retraux-design/accelerator-devkit/hardware/proto-0/baseboard/accelerator-devkit-proto-0-baseboard.kicad_pcb

## KiCad design hardware/proto-0/baseboard/accelerator-devkit-proto-0-baseboard.kicad_pcb (2020-06-28)

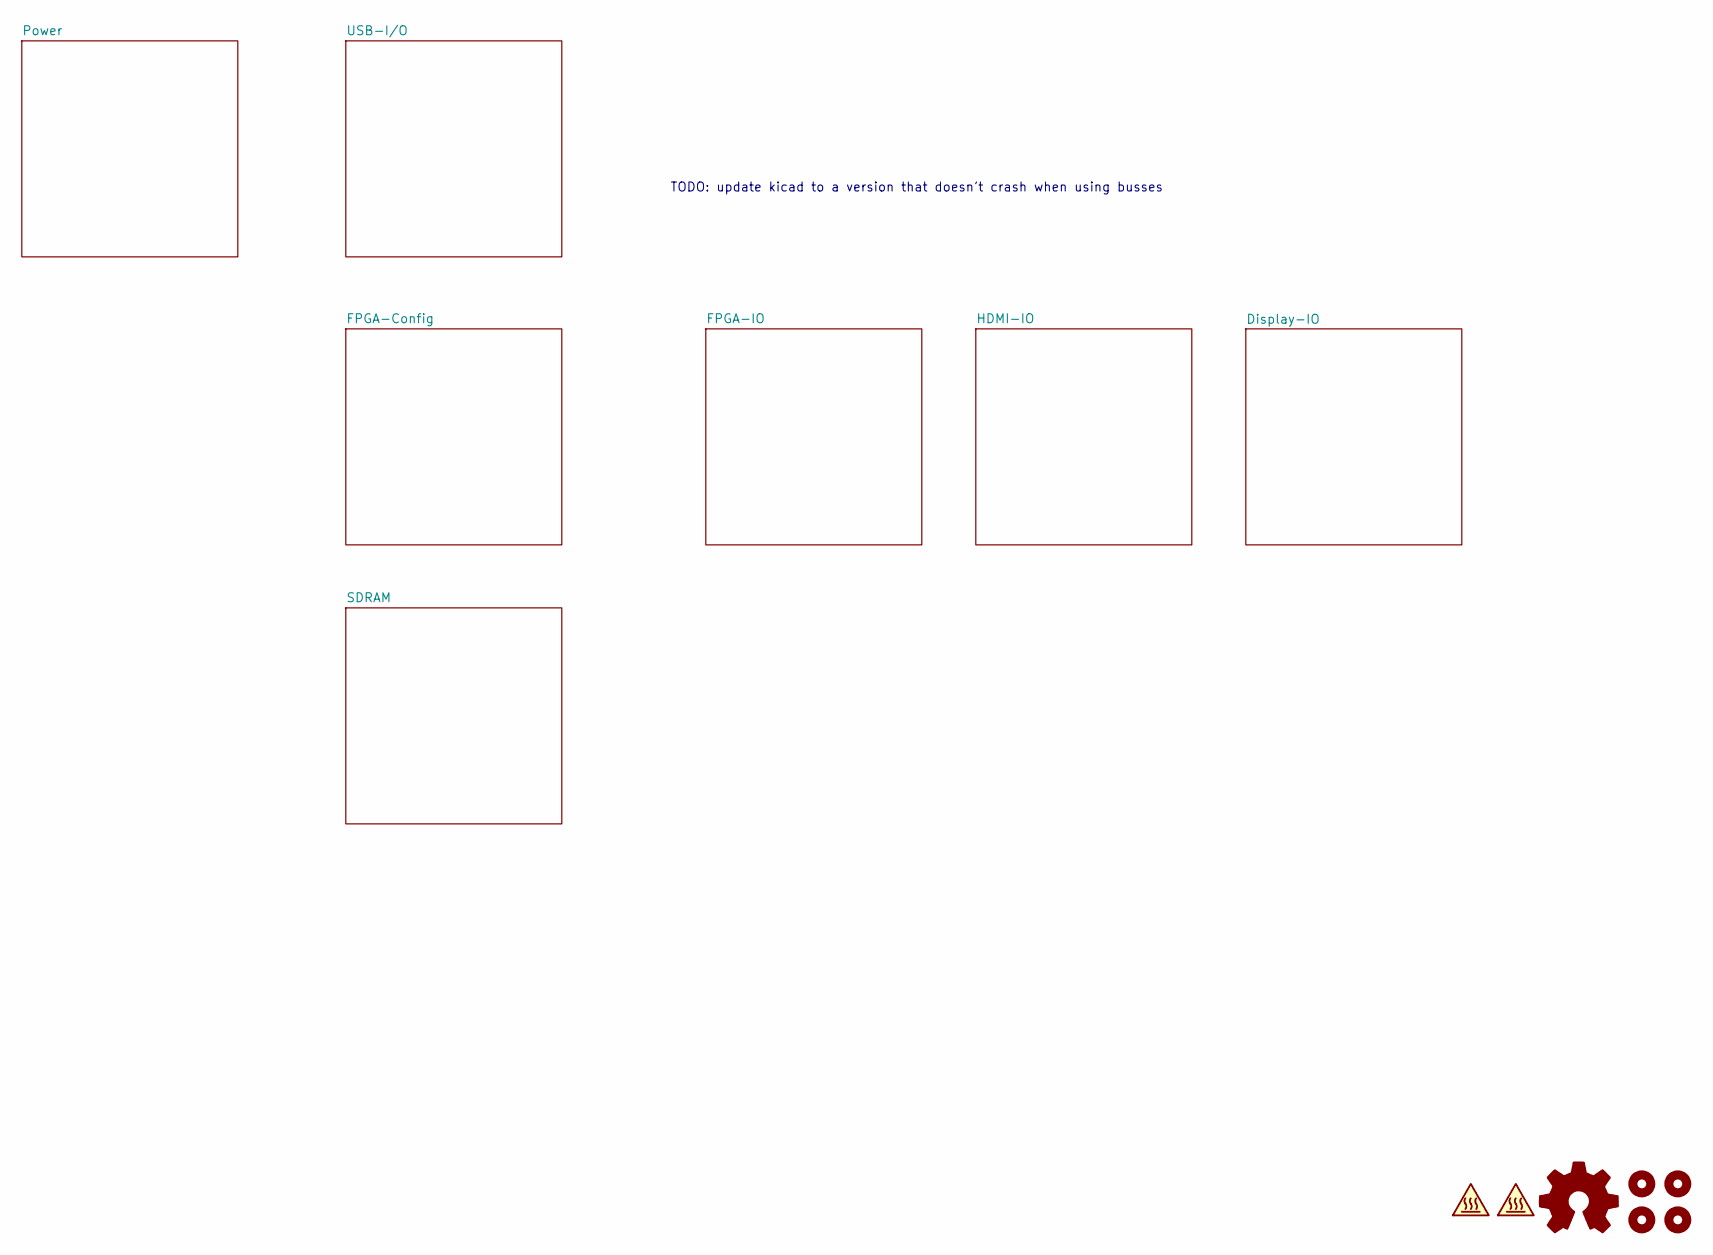
[picture p1: schematic accelerator-devkit-proto-0-baseboard.kicad_sch, Top]

Parts:
H1, H2, H3, H4: MountingHole; MountingHole_2.2mm_M2_Pad_Via
LOGO1: Logo_Open_Hardware_Small; OSHW-Symbol_6.7x6mm_Copper
LOGO2, LOGO3: SYM_Hot_Small; OSHW-Logo2_7.3x6mm_Copper

Notes on the sheet:
TODO: update kicad to a version that doesn't crash when using busses

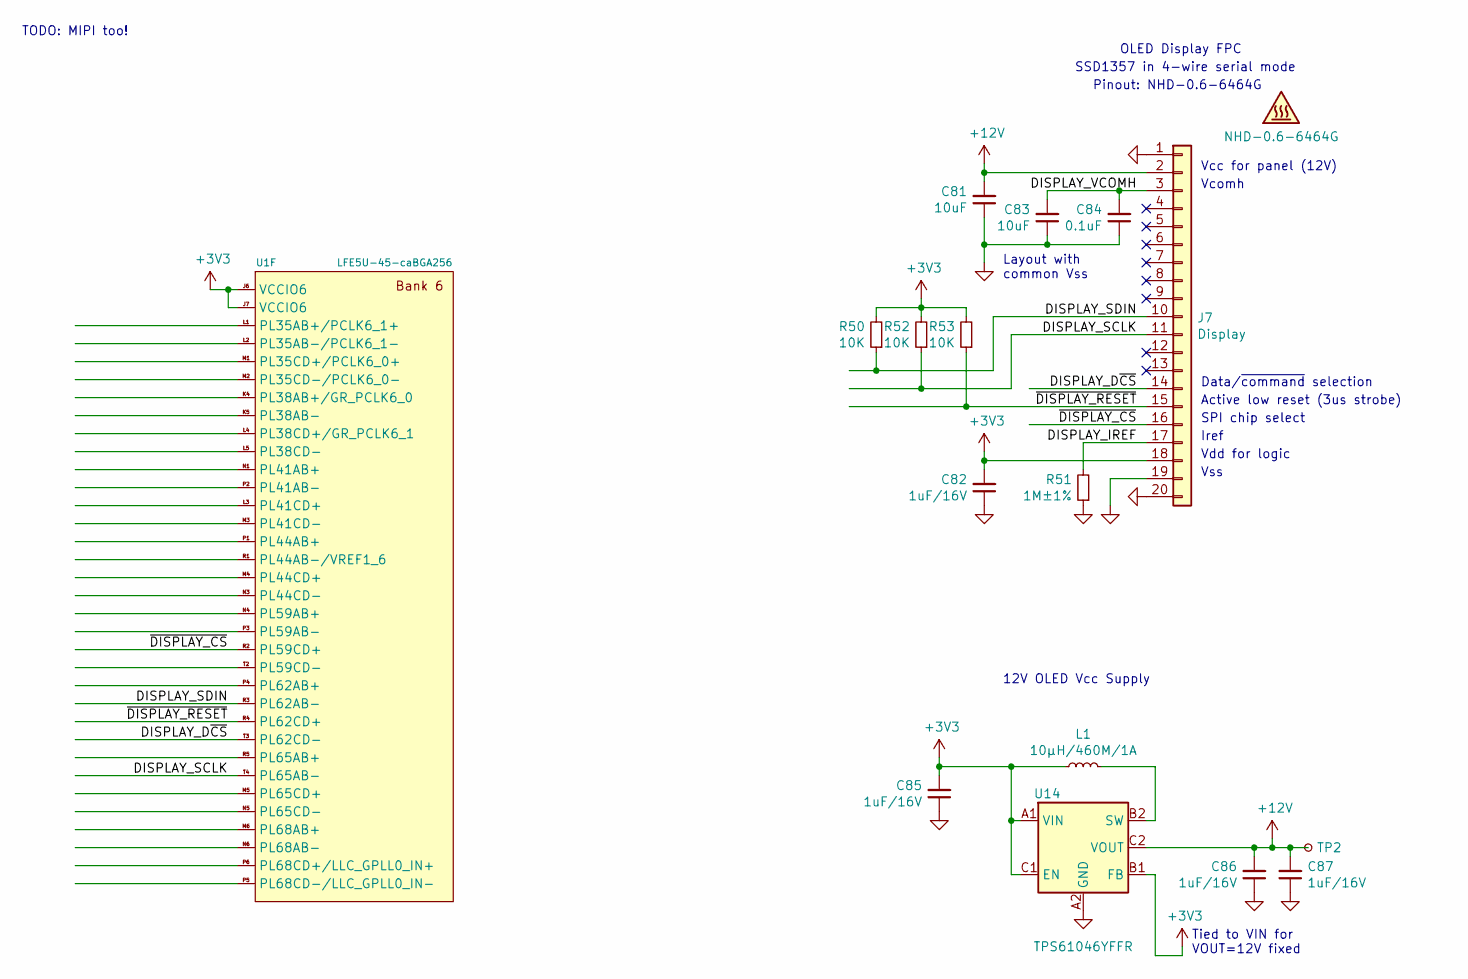
[picture p2: schematic accelerator-devkit-proto-0-baseboard-display-io.kicad_sch, Embedded Display TX]

Parts:
C81, C83: 10uF; C_0402_1005Metric
C82, C85, C86, C87: 1uF/16V; C_0402_1005Metric
C84: 0.1uF; C_0402_1005Metric
DISPLAY1: NHD-0.6-6464G
J7: Display; Molex_FFC-FPC_52745-2033_1x20_P0.5mm_TopContact
L1: 10µH/460M/1A; L_1008_2520Metric; Part 1239AS-H-100M=P2
R50, R52, R53: 10K; R_0402_1005Metric
R51: 1M±1%; R_0402_1005Metric
TP2: TestPoint_Small; TestPoint_THTPad_D1.0mm_Drill0.5mm
U1: LFE5U-45-caBGA256; Lattice_caBGA-256_14x14mm_P0.8mm
U14: TPS61046YFFR; Texas_DSBGA-6_0.8x1.2mm_Layout2x3_P0.4mm

Connections:
+3V3: C82.2, C85.2, J7.18, L1.1, R50.2, R52.2, R53.2, U1.J6 (VCCIO6), U1.J7 (VCCIO6), U14.A1 (VIN), U14.B1 (FB), U14.C1 (EN); also elsewhere on the board
+12V: C81.2, C86.2, C87.2, J7.2, TP2.1, U14.C2 (VOUT)
/Display-IO/DISPLAY_D~CS: J7.14, U1.T3 (PL62CD-)
/Display-IO/DISPLAY_IREF: J7.17, R51.2
/Display-IO/DISPLAY_SCLK: J7.11, R52.1, U1.T4 (PL65AB-)
/Display-IO/DISPLAY_SDIN: J7.10, R50.1, U1.R3 (PL62AB-)
/Display-IO/DISPLAY_VCOMH: C83.2, C84.2, J7.3
/Display-IO/~DISPLAY_CS: J7.16, U1.R2 (PL59CD+)
/Display-IO/~DISPLAY_RESET: J7.15, R53.1, U1.R4 (PL62CD+)
GND: C81.1, C82.1, C83.1, C84.1, C85.1, C86.1, C87.1, J7.1, J7.19, J7.20, R51.1, U14.A2 (GND); also elsewhere on the board
unnamed: L1.2, U14.B2 (SW)

Notes on the sheet:
TODO: MIPI too!
Layout with common Vss
12V OLED Vcc Supply
SSD1357 in 4-wire serial mode
Pinout: NHD-0.6-6464G
OLED Display FPC
Tied to VIN for VOUT=12V fixed
Vcc for panel (12V)
Vcomh
Data/~command~ selection
Active low reset (3us strobe)
SPI chip select
Iref
Vdd for logic
Vss

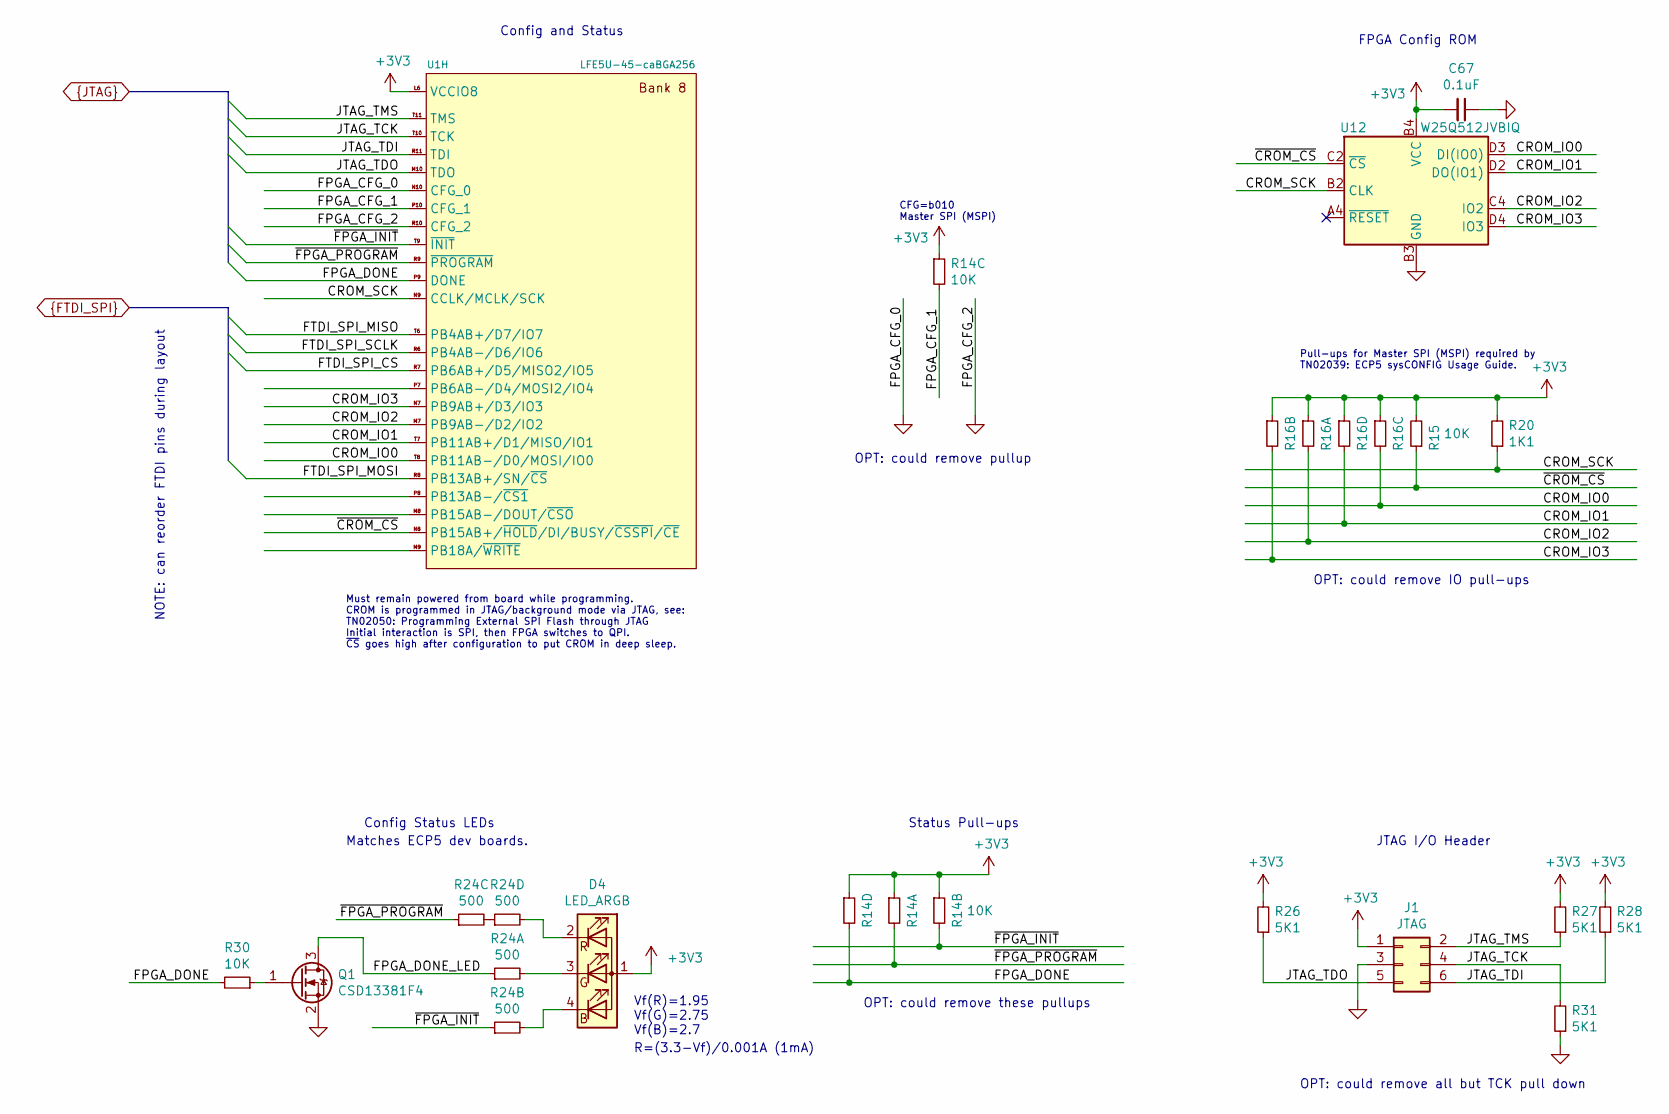
[picture p3: schematic accelerator-devkit-proto-0-baseboard-fpga-config.kicad_sch, FPGA Config]

Parts:
C67: 0.1uF; C_0402_1005Metric
D4: LED_ARGB; SML-LX0404SIUPGUSB; Part SML-LX0404SIUPGUSB
J1: JTAG; Tag-Connect_TC2030-IDC-NL_2x03_P1.27mm_Vertical_Outlined
Q1: CSD13381F4; Texas_DFN100X60X35-3N
R14, R16: 10K; R_Array_Concave_4x0402
R15, R30: 10K; R_0402_1005Metric
R20: 1K1; R_0402_1005Metric
R24: 500; R_Array_Concave_4x0402
R26, R27, R28, R31: 5K1; R_0402_1005Metric
U1: LFE5U-45-caBGA256; Lattice_caBGA-256_14x14mm_P0.8mm
U12: W25Q512JVBIQ; Winbond_TFBGA-24-5x5mm_P1.0mm

Connections:
+3V3: C67.2, D4.1 (A), J1.1, R14.1, R14.2, R14.3, R14.4, R15.2, R16.1, R16.2, R16.3, R16.4, R20.2, R26.2, R27.2, R28.2, U1.L6 (VCCIO8), U12.B4 (VCC); also elsewhere on the board
/FPGA-Config/CROM_IO0: R16.6, U1.T8 (PB11AB-/D0/MOSI/IO0), U12.D3 (DI(IO0))
/FPGA-Config/CROM_IO1: R16.5, U1.T7 (PB11AB+/D1/MISO/IO1), U12.D2 (DO(IO1))
/FPGA-Config/CROM_IO2: R16.8, U1.M7 (PB9AB-/D2/IO2), U12.C4 (IO2)
/FPGA-Config/CROM_IO3: R16.7, U1.N7 (PB9AB+/D3/IO3), U12.D4 (IO3)
/FPGA-Config/CROM_SCK: R20.1, U1.N9 (CCLK/MCLK/SCK), U12.B2 (CLK)
/FPGA-Config/FPGA_CFG_1: R14.6, U1.P10 (CFG_1)
/FPGA-Config/FPGA_DONE_LED: Q1.3 (D), R24.1
/FPGA-Config/~CROM_CS: R15.1, U1.N8 (PB15AB+/~HOLD~/DI/BUSY/~CSSPI~/~CE~), U12.C2 (~CS)
FPGA_DONE: R14.5, R30.2, U1.P9 (DONE); also elsewhere on the board
FTDI_SPI_CS: U1.R7 (PB6AB+/D5/MISO2/IO5); also elsewhere on the board
FTDI_SPI_MISO: U1.T6 (PB4AB+/D7/IO7); also elsewhere on the board
FTDI_SPI_MOSI: U1.R8 (PB13AB+/SN/~CS); also elsewhere on the board
FTDI_SPI_SCLK: U1.R6 (PB4AB-/D6/IO6); also elsewhere on the board
GND: C67.1, J1.3, Q1.2 (S), R31.1, U1.N10 (CFG_0), U1.R10 (CFG_2), U12.B3 (GND); also elsewhere on the board
JTAG_TCK: J1.4, R31.2, U1.T10 (TCK); also elsewhere on the board
JTAG_TDI: J1.6, R28.1, U1.R11 (TDI); also elsewhere on the board
JTAG_TDO: J1.5, R26.1, U1.M10 (TDO); also elsewhere on the board
JTAG_TMS: J1.2, R27.1, U1.T11 (TMS); also elsewhere on the board
unnamed: D4.2 (RK), R24.5
unnamed: D4.3 (GK), R24.8
unnamed: D4.4 (BK), R24.7
unnamed: Q1.1 (G), R30.1
unnamed: R24.4, R24.6
~FPGA_INIT: R14.7, R24.2, U1.T9 (~INIT); also elsewhere on the board
~FPGA_PROGRAM: R14.8, R24.3, U1.R9 (~PROGRAM); also elsewhere on the board

Notes on the sheet:
NOTE: can reorder FTDI pins during layout
Must remain powered from board while programming. CROM is programmed in JTAG/background mode via JTAG, see: TN02050: Programming External SPI Flash through JTAG Initial interaction is SPI, then FPGA switches to QPI. ~CS~ goes high after configuration to put CROM in deep sleep.
Matches ECP5 dev boards.
Config Status LEDs
Config and Status
Vf(R)=1.95 Vf(G)=2.75 Vf(B)=2.7
R=(3.3-Vf)/0.001A (1mA)
OPT: could remove pullup
OPT: could remove these pullups
CFG=b010 Master SPI (MSPI)
Status Pull-ups
Pull-ups for Master SPI (MSPI) required by TN02039: ECP5 sysCONFIG Usage Guide.
OPT: could remove all but TCK pull down
OPT: could remove IO pull-ups
FPGA Config ROM
JTAG I/O Header

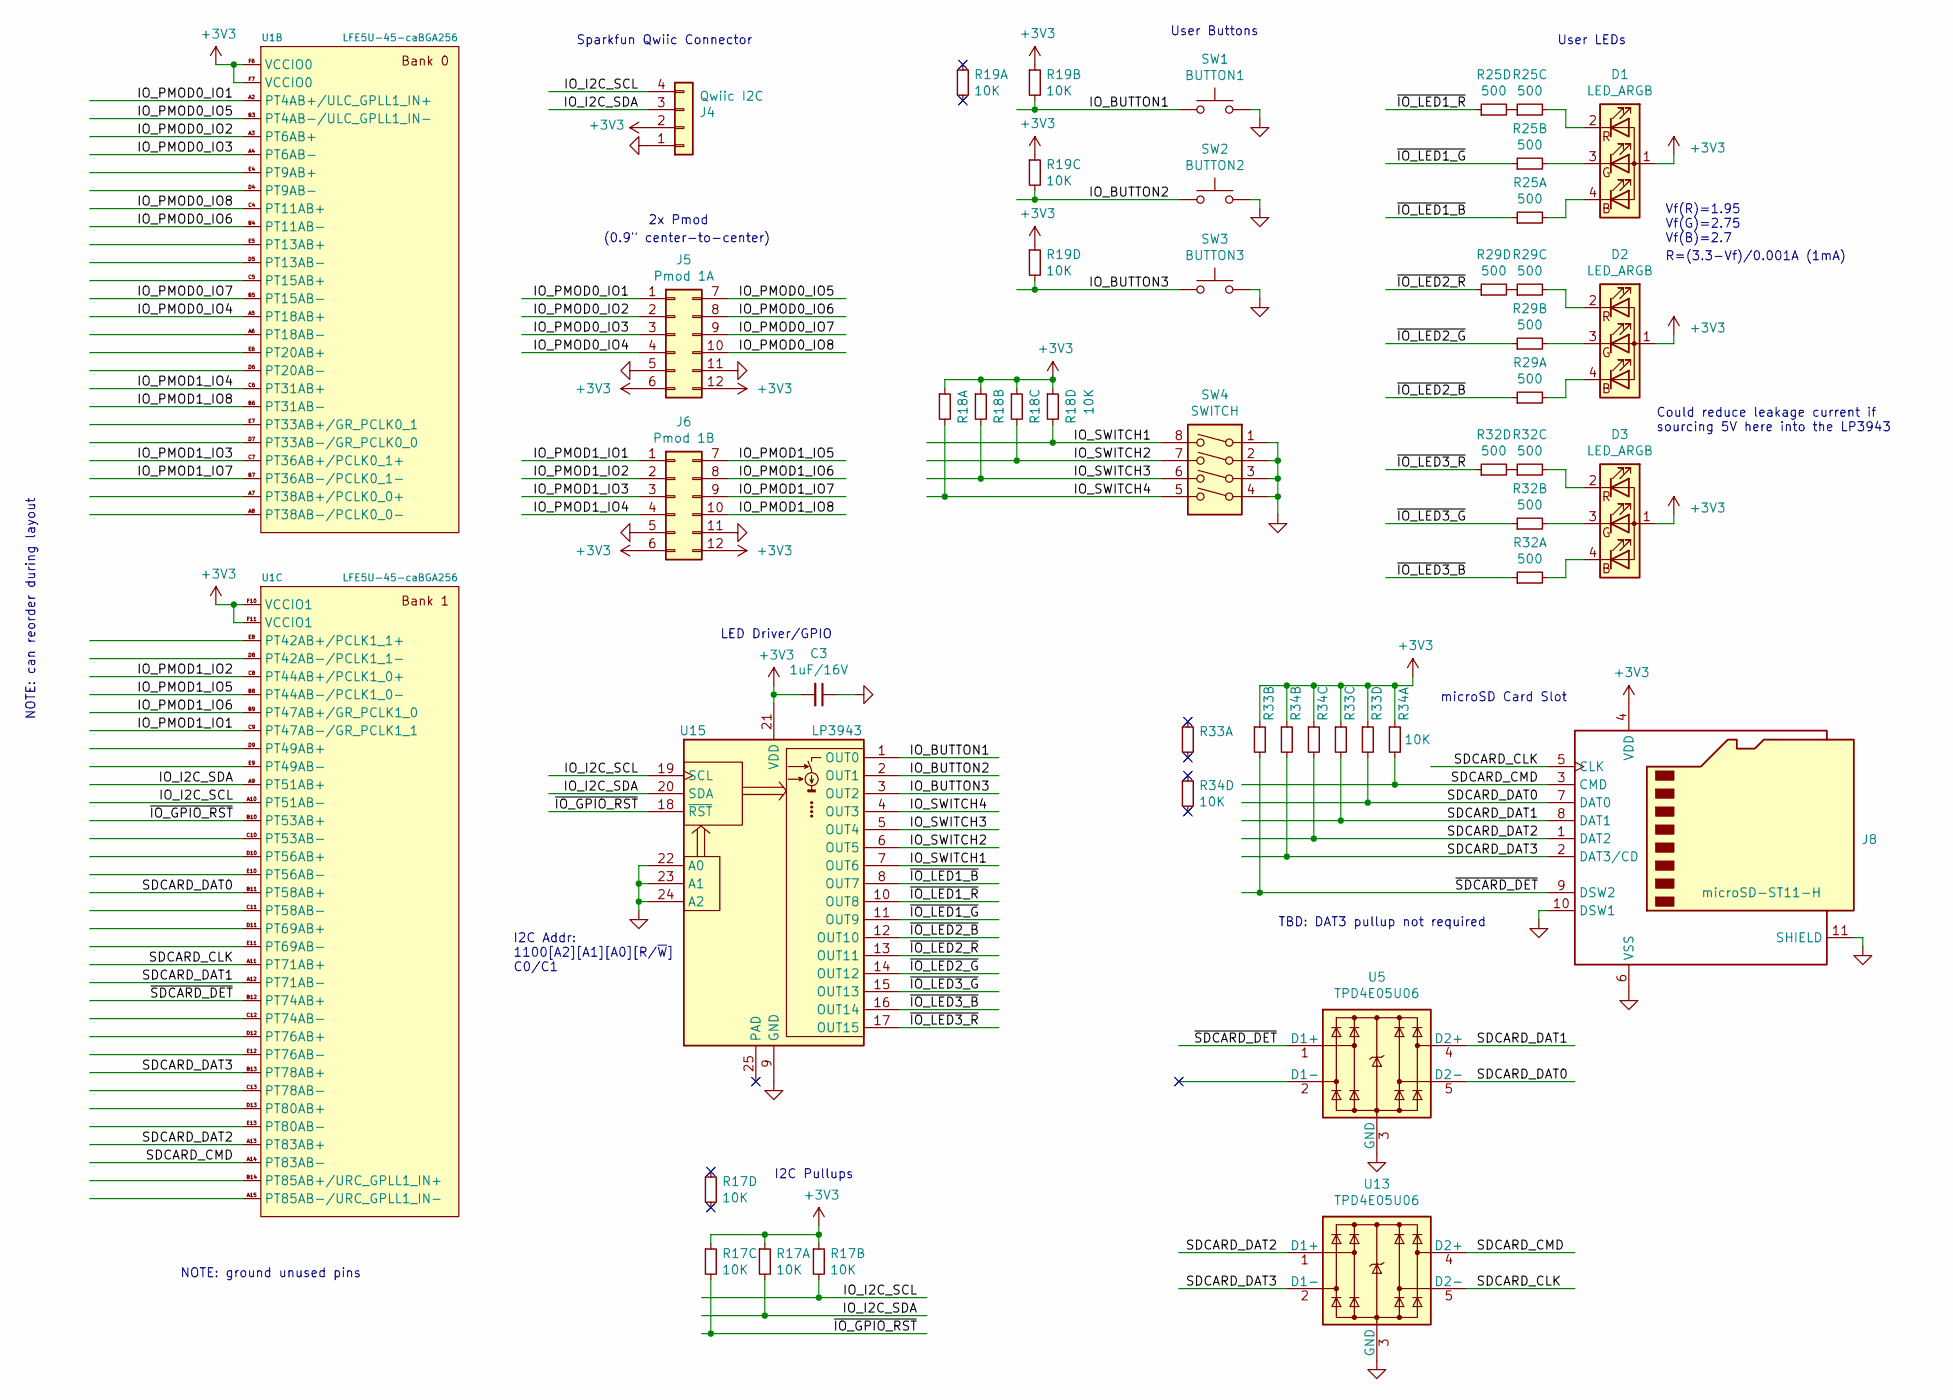
[picture p4: schematic accelerator-devkit-proto-0-baseboard-fpga-io.kicad_sch, FPGA I/O]

Parts:
C3: 1uF/16V; C_0402_1005Metric
D1, D2, D3: LED_ARGB; SML-LX0404SIUPGUSB; Part SML-LX0404SIUPGUSB
J4: Qwiic I2C; Qwiic_JST_SH_BM04B-SRSS-TB_1x04-1MP_P1.00mm_Vertical
J5: Pmod 1A; Pmod_2Stacked_PinSocket_2x06_P2.54mm_Horizontal
J6: Pmod 1B; Pmod_2Stacked_PinSocket_2x06_P2.54mm_Horizontal
J8: microSD-ST11-H; microSD_HC_JAE_ST11-H_ST11S008V4HR2000
R17, R18, R19, R33, R34: 10K; R_Array_Concave_4x0402
R25, R29, R32: 500; R_Array_Concave_4x0402
SW1: BUTTON1; PTS830GG140SMTRLFS; Part PTS830GM140
SW2: BUTTON2; PTS830GG140SMTRLFS; Part PTS830GM140
SW3: BUTTON3; PTS830GG140SMTRLFS; Part PTS830GM140
SW4: SWITCH; CVS-04TB; Part CVS-04TB
U1: LFE5U-45-caBGA256; Lattice_caBGA-256_14x14mm_P0.8mm
U5, U13: TPD4E05U06; USON-10_2.5x1.0mm_P0.5mm
U15: LP3943; Texas_S-PVQFN-N24_EP2.1x2.1mm

Connections:
+3V3: C3.2, D1.1 (A), D2.1 (A), D3.1 (A), J4.2, J5.6, J5.12, J6.6, J6.12, J8.4 (VDD), R17.1, R17.2, R17.3, R18.1, R18.2, R18.3, R18.4, R19.2, R19.3, R19.4, R33.2, R33.3, R33.4, R34.1, R34.2, R34.3, U1.F6 (VCCIO0), U1.F7 (VCCIO0), U1.F10 (VCCIO1), U1.F11 (VCCIO1), U15.21 (VDD); also elsewhere on the board
/FPGA-IO/IO_BUTTON1: R19.7, SW1.1, SW1.3, U15.1 (OUT0)
/FPGA-IO/IO_BUTTON2: R19.6, SW2.1, SW2.3, U15.2 (OUT1)
/FPGA-IO/IO_BUTTON3: R19.5, SW3.1, SW3.3, U15.3 (OUT2)
/FPGA-IO/IO_I2C_SCL: J4.4, R17.7, U1.A10 (PT51AB-), U15.19 (SCL)
/FPGA-IO/IO_I2C_SDA: J4.3, R17.8, U1.A9 (PT51AB+), U15.20 (SDA)
/FPGA-IO/IO_PMOD0_IO1: J5.1, U1.A2 (PT4AB+/ULC_GPLL1_IN+)
/FPGA-IO/IO_PMOD0_IO2: J5.2, U1.A3 (PT6AB+)
/FPGA-IO/IO_PMOD0_IO3: J5.3, U1.A4 (PT6AB-)
/FPGA-IO/IO_PMOD0_IO4: J5.4, U1.A5 (PT18AB+)
/FPGA-IO/IO_PMOD0_IO5: J5.7, U1.B3 (PT4AB-/ULC_GPLL1_IN-)
/FPGA-IO/IO_PMOD0_IO6: J5.8, U1.B4 (PT11AB-)
/FPGA-IO/IO_PMOD0_IO7: J5.9, U1.B5 (PT15AB-)
/FPGA-IO/IO_PMOD0_IO8: J5.10, U1.C4 (PT11AB+)
/FPGA-IO/IO_PMOD1_IO1: J6.1, U1.C9 (PT47AB-/GR_PCLK1_1)
/FPGA-IO/IO_PMOD1_IO2: J6.2, U1.C8 (PT44AB+/PCLK1_0+)
/FPGA-IO/IO_PMOD1_IO3: J6.3, U1.C7 (PT36AB+/PCLK0_1+)
/FPGA-IO/IO_PMOD1_IO4: J6.4, U1.C6 (PT31AB+)
/FPGA-IO/IO_PMOD1_IO5: J6.7, U1.B8 (PT44AB-/PCLK1_0-)
/FPGA-IO/IO_PMOD1_IO6: J6.8, U1.B9 (PT47AB+/GR_PCLK1_0)
/FPGA-IO/IO_PMOD1_IO7: J6.9, U1.B7 (PT36AB-/PCLK0_1-)
/FPGA-IO/IO_PMOD1_IO8: J6.10, U1.B6 (PT31AB-)
/FPGA-IO/IO_SWITCH1: R18.5, SW4.8, U15.7 (OUT6)
/FPGA-IO/IO_SWITCH2: R18.6, SW4.7, U15.6 (OUT5)
/FPGA-IO/IO_SWITCH3: R18.7, SW4.6, U15.5 (OUT4)
/FPGA-IO/IO_SWITCH4: R18.8, SW4.5, U15.4 (OUT3)
/FPGA-IO/SDCARD_CLK: J8.5 (CLK), U1.A11 (PT71AB+), U13.5 (D2-), U13.6 (D2-)
/FPGA-IO/SDCARD_CMD: J8.3 (CMD), R34.8, U1.A14 (PT83AB-), U13.4 (D2+), U13.7 (D2+)
/FPGA-IO/SDCARD_DAT0: J8.7 (DAT0), R33.5, U1.B11 (PT58AB+), U5.5 (D2-), U5.6 (D2-)
/FPGA-IO/SDCARD_DAT1: J8.8 (DAT1), R33.6, U1.A12 (PT71AB-), U5.4 (D2+), U5.7 (D2+)
/FPGA-IO/SDCARD_DAT2: J8.1 (DAT2), R34.6, U1.A13 (PT83AB+), U13.1 (D1+), U13.10 (D1+)
/FPGA-IO/SDCARD_DAT3: J8.2 (DAT3/CD), R34.7, U1.B13 (PT78AB+), U13.2 (D1-), U13.9 (D1-)
/FPGA-IO/~IO_GPIO_RST: R17.6, U1.B10 (PT53AB+), U15.18 (~RST)
/FPGA-IO/~IO_LED1_B: R25.1, U15.8 (OUT7)
/FPGA-IO/~IO_LED1_G: R25.2, U15.11 (OUT9)
/FPGA-IO/~IO_LED1_R: R25.4, U15.10 (OUT8)
/FPGA-IO/~IO_LED2_B: R29.1, U15.12 (OUT10)
/FPGA-IO/~IO_LED2_G: R29.2, U15.14 (OUT12)
/FPGA-IO/~IO_LED2_R: R29.4, U15.13 (OUT11)
/FPGA-IO/~IO_LED3_B: R32.1, U15.16 (OUT14)
/FPGA-IO/~IO_LED3_G: R32.2, U15.15 (OUT13)
/FPGA-IO/~IO_LED3_R: R32.4, U15.17 (OUT15)
/FPGA-IO/~SDCARD_DET: J8.9 (DSW2), R33.7, U1.B12 (PT74AB+), U5.1 (D1+), U5.10 (D1+)
GND: C3.1, J4.1, J5.5, J5.11, J6.5, J6.11, J8.6 (VSS), J8.10 (DSW1), J8.11 (SHIELD), SW1.2, SW1.4, SW2.2, SW2.4, SW3.2, SW3.4, SW4.1, SW4.2, SW4.3, SW4.4, U5.3 (GND), U5.8 (GND), U13.3 (GND), U13.8 (GND), U15.9 (GND), U15.22 (A0), U15.23 (A1), U15.24 (A2); also elsewhere on the board
unnamed: D1.2 (RK), R25.6
unnamed: D1.3 (GK), R25.7
unnamed: D1.4 (BK), R25.8
unnamed: D2.2 (RK), R29.6
unnamed: D2.3 (GK), R29.7
unnamed: D2.4 (BK), R29.8
unnamed: D3.2 (RK), R32.6
unnamed: D3.3 (GK), R32.7
unnamed: D3.4 (BK), R32.8
unnamed: R25.3, R25.5
unnamed: R29.3, R29.5
unnamed: R32.3, R32.5
unnamed: U5.2 (D1-), U5.9 (D1-)

Notes on the sheet:
NOTE: can reorder during layout
NOTE: ground unused pins
I2C Addr: 1100[A2][A1][A0][R/~W~] C0/C1
Sparkfun Qwiic Connector
(0.9" center-to-center)
2x Pmod
LED Driver/GPIO
I2C Pullups
User Buttons
TBD: DAT3 pullup not required
microSD Card Slot
User LEDs
Could reduce leakage current if sourcing 5V here into the LP3943
Vf(R)=1.95 Vf(G)=2.75 Vf(B)=2.7
R=(3.3-Vf)/0.001A (1mA)

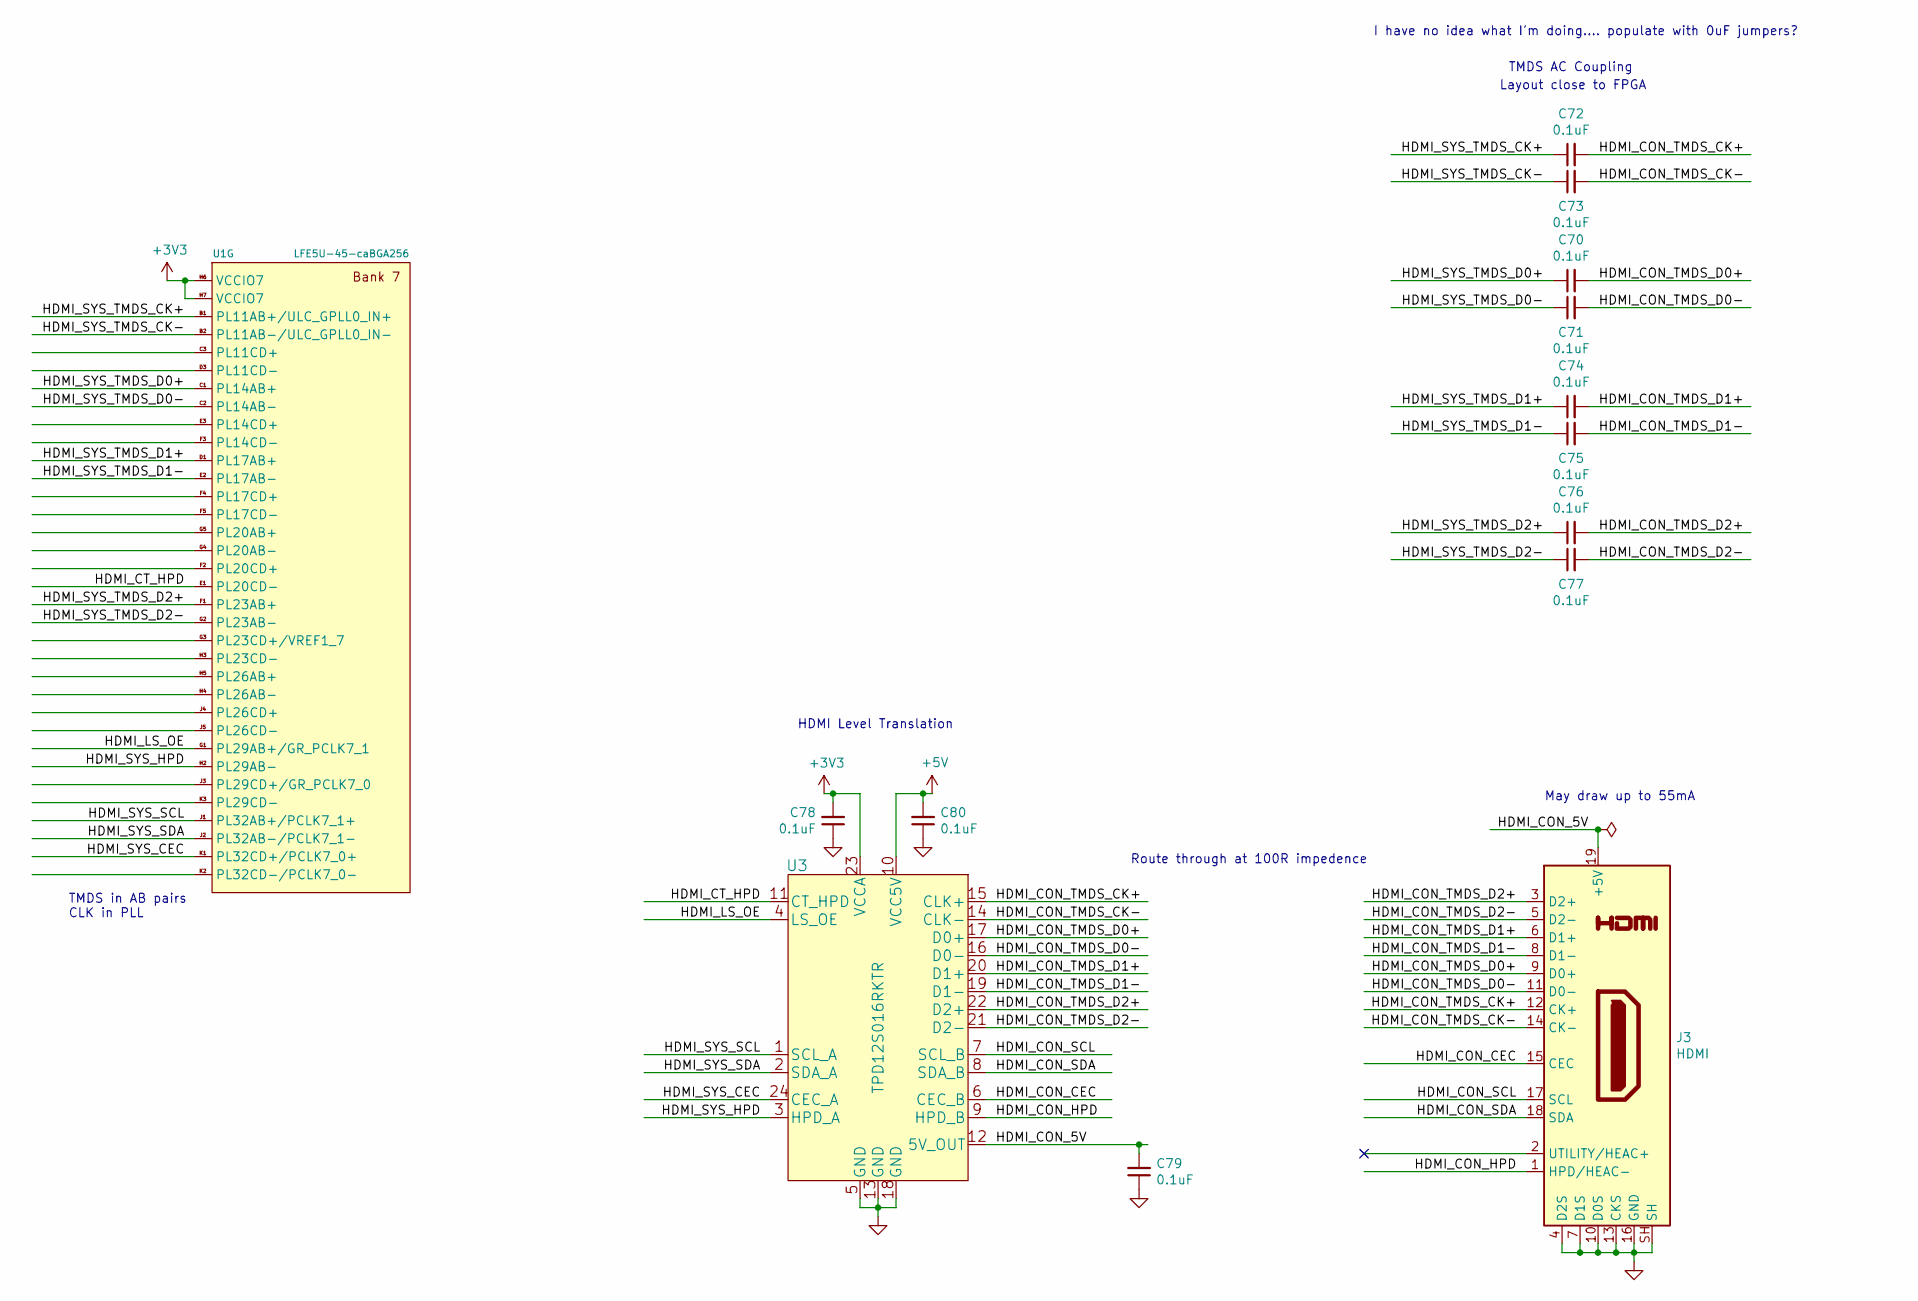
[picture p5: schematic accelerator-devkit-proto-0-baseboard-hdmi-io.kicad_sch, Display TX (MIPI/HDMI)]

Parts:
C70, C71, C72, C73, C74, C75, C76, C77: 0.1uF; C_0201_0603Metric
C78, C79, C80: 0.1uF; C_0402_1005Metric
J3: HDMI; HDMI_Micro-D_Molex_46765-0x01
U1: LFE5U-45-caBGA256; Lattice_caBGA-256_14x14mm_P0.8mm
U3: TPD12S016RKTR; Texas_UQFN-24_4x2mm_P0.4mm_RKTR

Connections:
+3V3: C78.2, U1.H6 (VCCIO7), U1.H7 (VCCIO7), U3.23 (VCCA); also elsewhere on the board
+5V: C80.2, U3.10 (VCC5V); also elsewhere on the board
/HDMI-IO/HDMI_CON_5V: C79.2, J3.19 (+5V), U3.12 (5V_OUT)
/HDMI-IO/HDMI_CON_CEC: J3.15 (CEC), U3.6 (CEC_B)
/HDMI-IO/HDMI_CON_HPD: J3.1 (HPD/HEAC-), U3.9 (HPD_B)
/HDMI-IO/HDMI_CON_SCL: J3.17 (SCL), U3.7 (SCL_B)
/HDMI-IO/HDMI_CON_SDA: J3.18 (SDA), U3.8 (SDA_B)
/HDMI-IO/HDMI_CON_TMDS_CK+: C72.2, J3.12 (CK+), U3.15 (CLK+)
/HDMI-IO/HDMI_CON_TMDS_CK-: C73.2, J3.14 (CK-), U3.14 (CLK-)
/HDMI-IO/HDMI_CON_TMDS_D0+: C70.2, J3.9 (D0+), U3.17 (D0+)
/HDMI-IO/HDMI_CON_TMDS_D0-: C71.2, J3.11 (D0-), U3.16 (D0-)
/HDMI-IO/HDMI_CON_TMDS_D1+: C74.2, J3.6 (D1+), U3.20 (D1+)
/HDMI-IO/HDMI_CON_TMDS_D1-: C75.2, J3.8 (D1-), U3.19 (D1-)
/HDMI-IO/HDMI_CON_TMDS_D2+: C76.2, J3.3 (D2+), U3.22 (D2+)
/HDMI-IO/HDMI_CON_TMDS_D2-: C77.2, J3.5 (D2-), U3.21 (D2-)
/HDMI-IO/HDMI_CT_HPD: U1.E1 (PL20CD-), U3.11 (CT_HPD)
/HDMI-IO/HDMI_LS_OE: U1.G1 (PL29AB+/GR_PCLK7_1), U3.4 (LS_OE)
/HDMI-IO/HDMI_SYS_CEC: U1.K1 (PL32CD+/PCLK7_0+), U3.24 (CEC_A)
/HDMI-IO/HDMI_SYS_HPD: U1.H2 (PL29AB-), U3.3 (HPD_A)
/HDMI-IO/HDMI_SYS_SCL: U1.J1 (PL32AB+/PCLK7_1+), U3.1 (SCL_A)
/HDMI-IO/HDMI_SYS_SDA: U1.J2 (PL32AB-/PCLK7_1-), U3.2 (SDA_A)
/HDMI-IO/HDMI_SYS_TMDS_CK+: C72.1, U1.B1 (PL11AB+/ULC_GPLL0_IN+)
/HDMI-IO/HDMI_SYS_TMDS_CK-: C73.1, U1.B2 (PL11AB-/ULC_GPLL0_IN-)
/HDMI-IO/HDMI_SYS_TMDS_D0+: C70.1, U1.C1 (PL14AB+)
/HDMI-IO/HDMI_SYS_TMDS_D0-: C71.1, U1.C2 (PL14AB-)
/HDMI-IO/HDMI_SYS_TMDS_D1+: C74.1, U1.D1 (PL17AB+)
/HDMI-IO/HDMI_SYS_TMDS_D1-: C75.1, U1.E2 (PL17AB-)
/HDMI-IO/HDMI_SYS_TMDS_D2+: C76.1, U1.F1 (PL23AB+)
/HDMI-IO/HDMI_SYS_TMDS_D2-: C77.1, U1.G2 (PL23AB-)
GND: C78.1, C79.1, C80.1, J3.4 (D2S), J3.7 (D1S), J3.10 (D0S), J3.13 (CKS), J3.16 (GND), J3.SH, U3.5 (GND), U3.13 (GND), U3.18 (GND); also elsewhere on the board

Notes on the sheet:
TMDS in AB pairs CLK in PLL
HDMI Level Translation
Route through at 100R impedence
I have no idea what I'm doing.... populate with 0uF jumpers?
Layout close to FPGA
TMDS AC Coupling
May draw up to 55mA

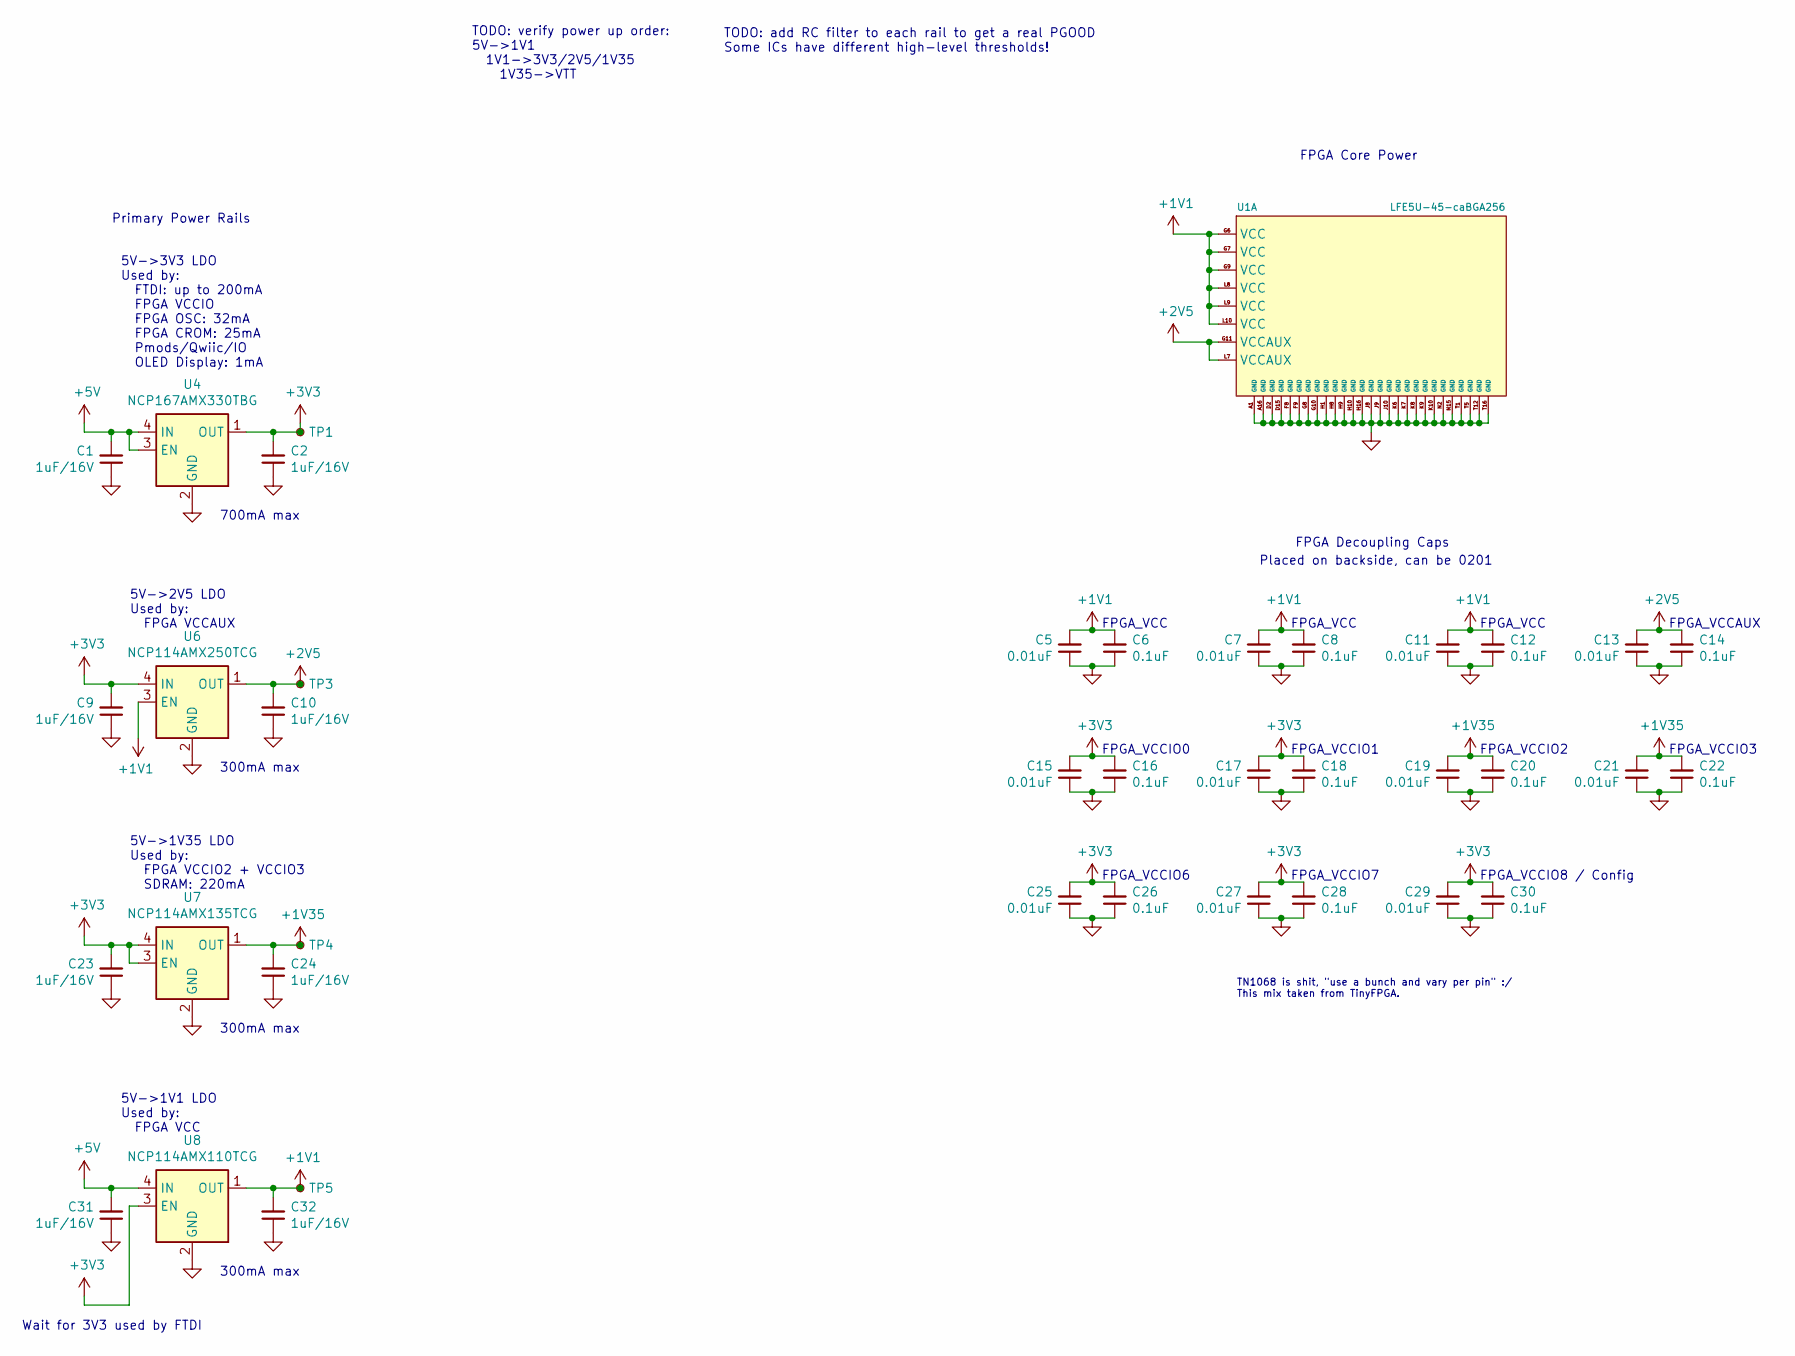
[picture p6: schematic accelerator-devkit-proto-0-baseboard-power.kicad_sch, Power]

Parts:
C1, C2, C9, C10, C23, C24, C31, C32: 1uF/16V; C_0402_1005Metric
C5, C7, C11, C13, C15, C17, C19, C21, C25, C27, C29: 0.01uF; C_0201_0603Metric
C6, C8, C12, C14, C16, C18, C20, C22, C26, C28, C30: 0.1uF; C_0201_0603Metric
TP1, TP3, TP4, TP5: TestPoint_Small; TestPoint_THTPad_D1.0mm_Drill0.5mm
U1: LFE5U-45-caBGA256; Lattice_caBGA-256_14x14mm_P0.8mm
U4: NCP167AMX330TBG; XDFN-4-1EP_1x1mm_P0.65mm_EP0.48x0.48mm
U6: NCP114AMX250TCG; UDFN-4-1EP_1x1mm_P0.65mm_EP0.48x0.48mm
U7: NCP114AMX135TCG; UDFN-4-1EP_1x1mm_P0.65mm_EP0.48x0.48mm
U8: NCP114AMX110TCG; UDFN-4-1EP_1x1mm_P0.65mm_EP0.48x0.48mm

Connections:
+1V1: C5.2, C6.2, C7.2, C8.2, C11.2, C12.2, C32.2, TP5.1, U1.G6 (VCC), U1.G7 (VCC), U1.G9 (VCC), U1.L8 (VCC), U1.L9 (VCC), U1.L10 (VCC), U6.3 (EN), U8.1 (OUT)
+1V35: C19.2, C20.2, C21.2, C22.2, C24.2, TP4.1, U7.1 (OUT); also elsewhere on the board
+2V5: C10.2, C13.2, C14.2, TP3.1, U1.G11 (VCCAUX), U1.L7 (VCCAUX), U6.1 (OUT)
+3V3: C2.2, C9.2, C15.2, C16.2, C17.2, C18.2, C23.2, C25.2, C26.2, C27.2, C28.2, C29.2, C30.2, TP1.1, U4.1 (OUT), U6.4 (IN), U7.3 (EN), U7.4 (IN), U8.3 (EN); also elsewhere on the board
+5V: C1.2, C31.2, U4.3 (EN), U4.4 (IN), U8.4 (IN); also elsewhere on the board
GND: C1.1, C2.1, C5.1, C6.1, C7.1, C8.1, C9.1, C10.1, C11.1, C12.1, C13.1, C14.1, C15.1, C16.1, C17.1, C18.1, C19.1, C20.1, C21.1, C22.1, C23.1, C24.1, C25.1, C26.1, C27.1, C28.1, C29.1, C30.1, C31.1, C32.1, U1.A1 (GND), U1.A16 (GND), U1.D2 (GND), U1.D15 (GND), U1.F8 (GND), U1.F9 (GND), U1.G8 (GND), U1.G10 (GND), U1.H1 (GND), U1.H8 (GND), U1.H9 (GND), U1.H10 (GND), U1.H16 (GND), U1.J8 (GND), U1.J9 (GND), U1.J10 (GND), U1.K6 (GND), U1.K7 (GND), U1.K8 (GND), U1.K9 (GND), U1.K10 (GND), U1.N2 (GND), U1.N15 (GND), U1.T1 (GND), U1.T5 (GND), U1.T12 (GND), U1.T16 (GND), U4.2 (GND), U4.5 (EPAD), U6.2 (GND), U6.5 (EPAD), U7.2 (GND), U7.5 (EPAD), U8.2 (GND), U8.5 (EPAD); also elsewhere on the board

Notes on the sheet:
Wait for 3V3 used by FTDI
Primary Power Rails
5V->3V3 LDO Used by: FTDI: up to 200mA FPGA VCCIO FPGA OSC: 32mA FPGA CROM: 25mA Pmods/Qwiic/IO OLED Display: 1mA
5V->1V1 LDO Used by: FPGA VCC
5V->2V5 LDO Used by: FPGA VCCAUX
5V->1V35 LDO Used by: FPGA VCCIO2 + VCCIO3 SDRAM: 220mA
700mA max
300mA max
TODO: verify power up order: 5V->1V1 1V1->3V3/2V5/1V35 1V35->VTT
TODO: add RC filter to each rail to get a real PGOOD Some ICs have different high-level thresholds!
FPGA_VCC
FPGA_VCCIO0
FPGA_VCCIO6
TN1068 is shit, "use a bunch and vary per pin" :/ This mix taken from TinyFPGA.
Placed on backside, can be 0201
FPGA_VCCIO1
FPGA_VCCIO7
FPGA Decoupling Caps
FPGA Core Power
FPGA_VCCIO2
FPGA_VCCIO8 / Config
FPGA_VCCAUX
FPGA_VCCIO3
