retraux-design/accelerator-devkit/hardware/proto-0/baseboard/accelerator-devkit-proto-0-baseboard.kicad_pcb

## KiCad design hardware/proto-0/baseboard/accelerator-devkit-proto-0-baseboard.kicad_pcb (continued)

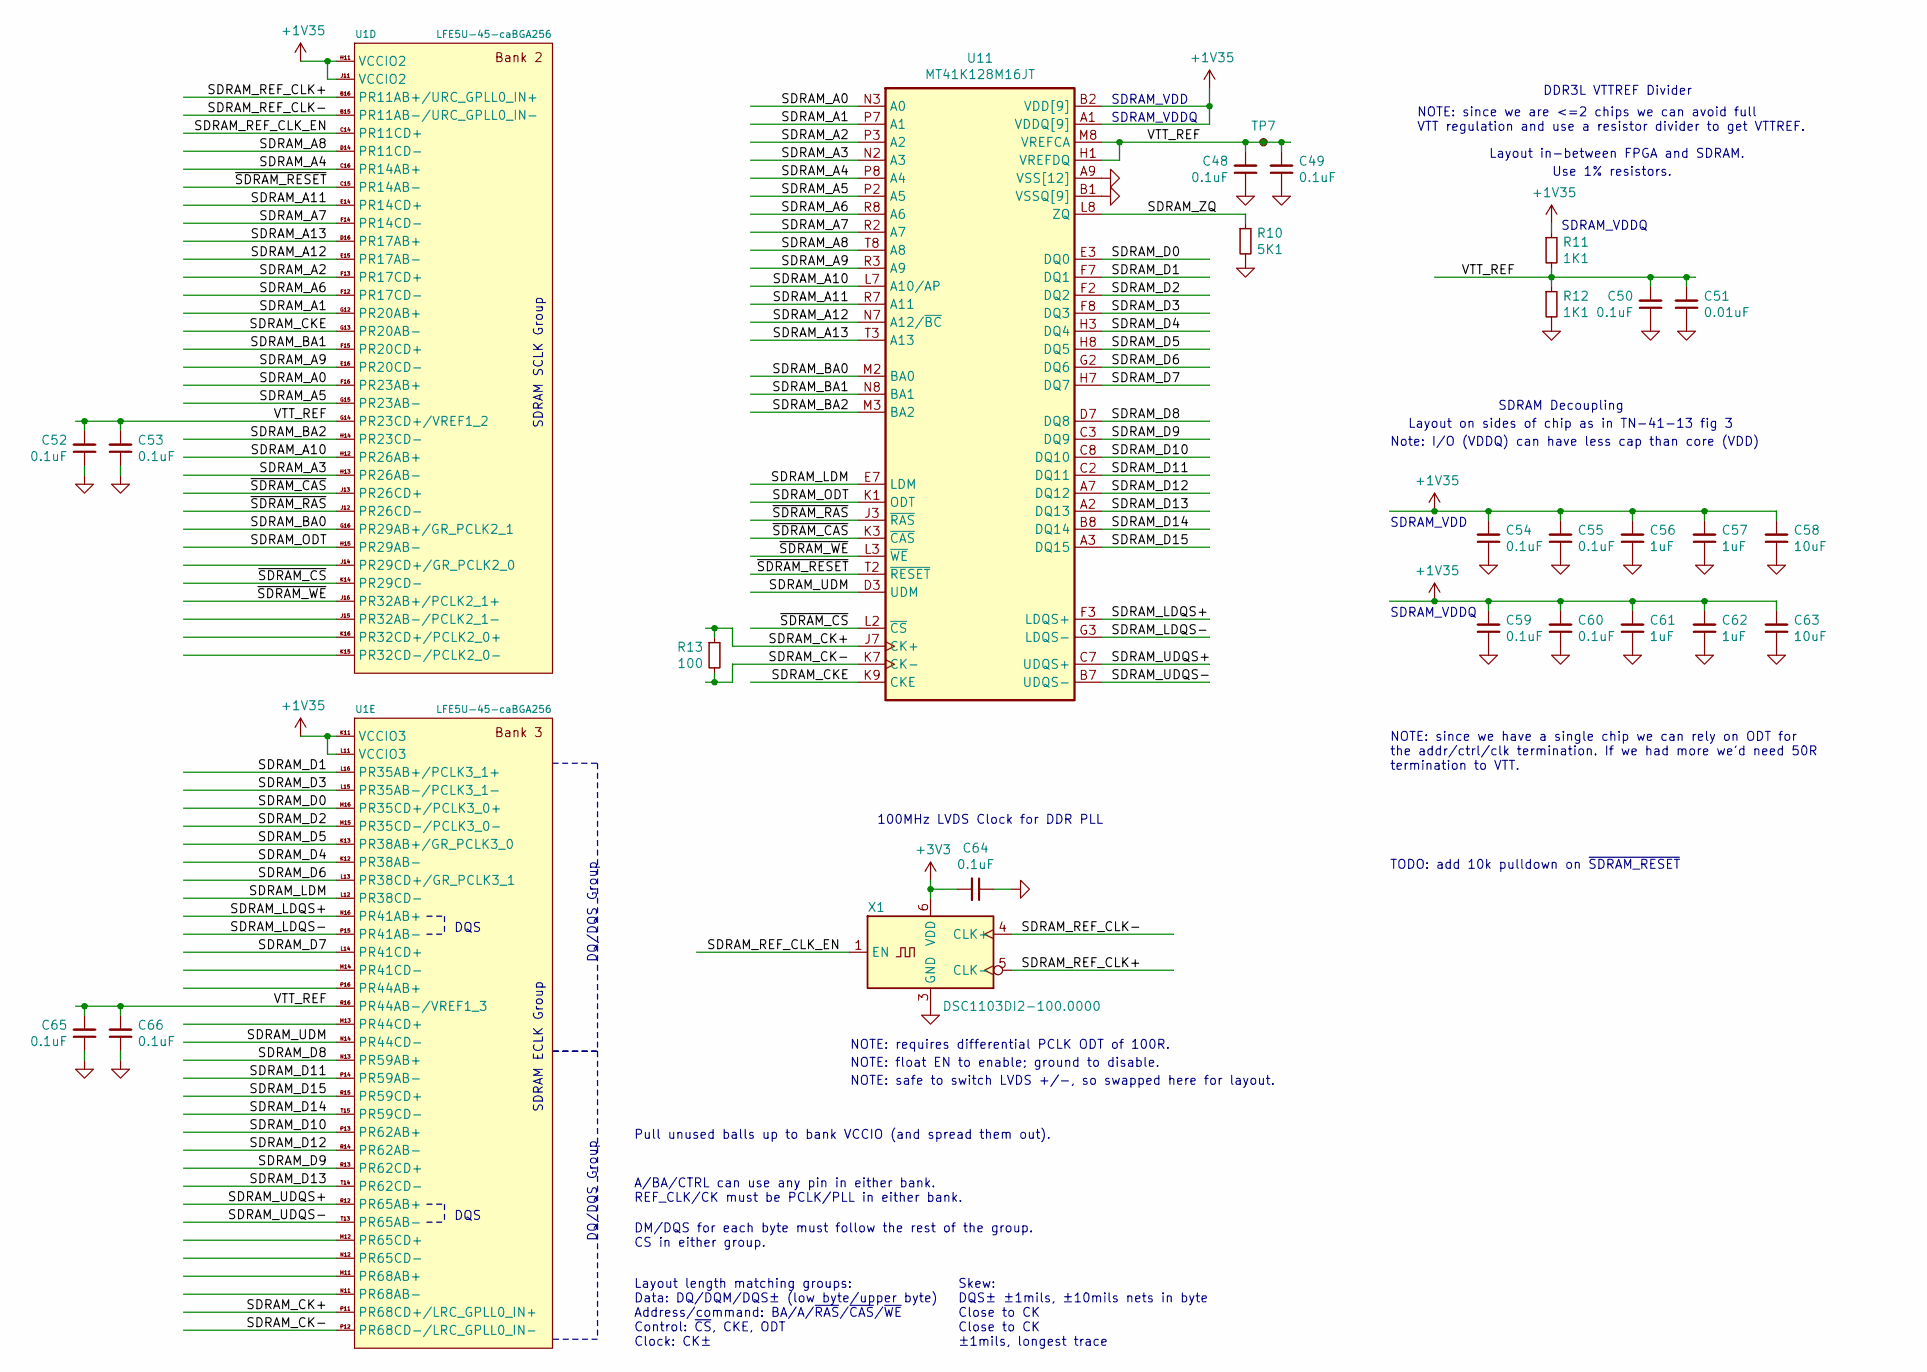
[picture p7: schematic accelerator-devkit-proto-0-baseboard-sdram.kicad_sch, SDRAM]

Parts:
C48, C49, C50, C52, C53, C54, C55, C59, C60, C65, C66: 0.1uF; C_0201_0603Metric
C51: 0.01uF; C_0201_0603Metric
C56, C57, C61, C62: 1uF; C_0201_0603Metric
C58, C63: 10uF; C_0402_1005Metric
C64: 0.1uF; C_0402_1005Metric
R10: 5K1; R_0402_1005Metric
R11, R12: 1K1; R_0402_1005Metric
R13: 100; R_0402_1005Metric
TP7: TestPoint_Small; TestPoint_Pad_D1.0mm
U1: LFE5U-45-caBGA256; Lattice_caBGA-256_14x14mm_P0.8mm
U11: MT41K128M16JT; BGA-96_9.0x13.0mm_Layout2x3x16_P0.8mm
X1: DSC1103DI2-100.0000; Oscillator_SMD_Microchip_VDFN-6Pin_2.5x2.0mm_J7A

Connections:
+1V35: C54.2, C55.2, C56.2, C57.2, C58.2, C59.2, C60.2, C61.2, C62.2, C63.2, R11.1, U1.H11 (VCCIO2), U1.J11 (VCCIO2), U1.K11 (VCCIO3), U1.L11 (VCCIO3), U11.A1 (VDDQ[9]), U11.A8 (VDDQ), U11.B2 (VDD[9]), U11.C1 (VDDQ), U11.C9 (VDDQ), U11.D2 (VDDQ), U11.D9 (VDD), U11.E9 (VDDQ), U11.F1 (VDDQ), U11.G7 (VDD), U11.H2 (VDDQ), U11.H9 (VDDQ), U11.K2 (VDD), U11.K8 (VDD), U11.N1 (VDD), U11.N9 (VDD), U11.R1 (VDD), U11.R9 (VDD); also elsewhere on the board
+3V3: C64.2, X1.6 (VDD); also elsewhere on the board
/SDRAM/SDRAM_A0: U1.F16 (PR23AB+), U11.N3 (A0)
/SDRAM/SDRAM_A1: U1.G12 (PR20AB+), U11.P7 (A1)
/SDRAM/SDRAM_A2: U1.F13 (PR17CD+), U11.P3 (A2)
/SDRAM/SDRAM_A3: U1.H13 (PR26AB-), U11.N2 (A3)
/SDRAM/SDRAM_A4: U1.C16 (PR14AB+), U11.P8 (A4)
/SDRAM/SDRAM_A5: U1.G15 (PR23AB-), U11.P2 (A5)
/SDRAM/SDRAM_A6: U1.F12 (PR17CD-), U11.R8 (A6)
/SDRAM/SDRAM_A7: U1.F14 (PR14CD-), U11.R2 (A7)
/SDRAM/SDRAM_A8: U1.D14 (PR11CD-), U11.T8 (A8)
/SDRAM/SDRAM_A9: U1.E16 (PR20CD-), U11.R3 (A9)
/SDRAM/SDRAM_A10: U1.H12 (PR26AB+), U11.L7 (A10/AP)
/SDRAM/SDRAM_A11: U1.E14 (PR14CD+), U11.R7 (A11)
/SDRAM/SDRAM_A12: U1.E15 (PR17AB-), U11.N7 (A12/~BC)
/SDRAM/SDRAM_A13: U1.D16 (PR17AB+), U11.T3 (A13)
/SDRAM/SDRAM_BA0: U1.G16 (PR29AB+/GR_PCLK2_1), U11.M2 (BA0)
/SDRAM/SDRAM_BA1: U1.F15 (PR20CD+), U11.N8 (BA1)
/SDRAM/SDRAM_BA2: U1.H14 (PR23CD-), U11.M3 (BA2)
/SDRAM/SDRAM_CK+: R13.1, U1.P11 (PR68CD+/LRC_GPLL0_IN+), U11.J7 (CK+)
/SDRAM/SDRAM_CK-: R13.2, U1.P12 (PR68CD-/LRC_GPLL0_IN-), U11.K7 (CK-)
/SDRAM/SDRAM_CKE: U1.G13 (PR20AB-), U11.K9 (CKE)
/SDRAM/SDRAM_D0: U1.M16 (PR35CD+/PCLK3_0+), U11.E3 (DQ0)
/SDRAM/SDRAM_D1: U1.L16 (PR35AB+/PCLK3_1+), U11.F7 (DQ1)
/SDRAM/SDRAM_D2: U1.M15 (PR35CD-/PCLK3_0-), U11.F2 (DQ2)
/SDRAM/SDRAM_D3: U1.L15 (PR35AB-/PCLK3_1-), U11.F8 (DQ3)
/SDRAM/SDRAM_D4: U1.K12 (PR38AB-), U11.H3 (DQ4)
/SDRAM/SDRAM_D5: U1.K13 (PR38AB+/GR_PCLK3_0), U11.H8 (DQ5)
/SDRAM/SDRAM_D6: U1.L13 (PR38CD+/GR_PCLK3_1), U11.G2 (DQ6)
/SDRAM/SDRAM_D7: U1.L14 (PR41CD+), U11.H7 (DQ7)
/SDRAM/SDRAM_D8: U1.N13 (PR59AB+), U11.D7 (DQ8)
/SDRAM/SDRAM_D9: U1.R13 (PR62CD+), U11.C3 (DQ9)
/SDRAM/SDRAM_D10: U1.P13 (PR62AB+), U11.C8 (DQ10)
/SDRAM/SDRAM_D11: U1.P14 (PR59AB-), U11.C2 (DQ11)
/SDRAM/SDRAM_D12: U1.R14 (PR62AB-), U11.A7 (DQ12)
/SDRAM/SDRAM_D13: U1.T14 (PR62CD-), U11.A2 (DQ13)
/SDRAM/SDRAM_D14: U1.T15 (PR59CD-), U11.B8 (DQ14)
/SDRAM/SDRAM_D15: U1.R15 (PR59CD+), U11.A3 (DQ15)
/SDRAM/SDRAM_LDM: U1.L12 (PR38CD-), U11.E7 (LDM)
/SDRAM/SDRAM_LDQS+: U1.N16 (PR41AB+), U11.F3 (LDQS+)
/SDRAM/SDRAM_LDQS-: U1.P15 (PR41AB-), U11.G3 (LDQS-)
/SDRAM/SDRAM_ODT: U1.H15 (PR29AB-), U11.K1 (ODT)
/SDRAM/SDRAM_REF_CLK+: U1.B16 (PR11AB+/URC_GPLL0_IN+), X1.5 (CLK-)
/SDRAM/SDRAM_REF_CLK-: U1.B15 (PR11AB-/URC_GPLL0_IN-), X1.4 (CLK+)
/SDRAM/SDRAM_REF_CLK_EN: U1.C14 (PR11CD+), X1.1 (EN)
/SDRAM/SDRAM_UDM: U1.N14 (PR44CD-), U11.D3 (UDM)
/SDRAM/SDRAM_UDQS+: U1.R12 (PR65AB+), U11.C7 (UDQS+)
/SDRAM/SDRAM_UDQS-: U1.T13 (PR65AB-), U11.B7 (UDQS-)
/SDRAM/SDRAM_ZQ: R10.1, U11.L8 (ZQ)
/SDRAM/VTT_REF: C48.2, C49.2, C50.2, C51.2, C52.2, C53.2, C65.2, C66.2, R11.2, R12.1, TP7.1, U1.G14 (PR23CD+/VREF1_2), U1.R16 (PR44AB-/VREF1_3), U11.H1 (VREFDQ), U11.M8 (VREFCA)
/SDRAM/~SDRAM_CAS: U1.J13 (PR26CD+), U11.K3 (~CAS)
/SDRAM/~SDRAM_CS: U1.K14 (PR29CD-), U11.L2 (~CS)
/SDRAM/~SDRAM_RAS: U1.J12 (PR26CD-), U11.J3 (~RAS)
/SDRAM/~SDRAM_RESET: U1.C15 (PR14AB-), U11.T2 (~RESET)
/SDRAM/~SDRAM_WE: U1.J16 (PR32AB+/PCLK2_1+), U11.L3 (~WE)
GND: C48.1, C49.1, C50.1, C51.1, C52.1, C53.1, C54.1, C55.1, C56.1, C57.1, C58.1, C59.1, C60.1, C61.1, C62.1, C63.1, C64.1, C65.1, C66.1, R10.2, R12.2, U11.A9 (VSS[12]), U11.B1 (VSSQ[9]), U11.B3 (VSS), U11.B9 (VSSQ), U11.D1 (VSSQ), U11.D8 (VSSQ), U11.E1 (VSS), U11.E2 (VSSQ), U11.E8 (VSSQ), U11.F9 (VSSQ), U11.G1 (VSSQ), U11.G8 (VSS), U11.G9 (VSSQ), U11.J2 (VSS), U11.J8 (VSS), U11.M1 (VSS), U11.M9 (VSS), U11.P1 (VSS), U11.P9 (VSS), U11.T1 (VSS), U11.T9 (VSS), X1.3 (GND); also elsewhere on the board

Notes on the sheet:
DQS
SDRAM SCLK Group
SDRAM ECLK Group
DQ/DQS Group
Pull unused balls up to bank VCCIO (and spread them out).
A/BA/CTRL can use any pin in either bank. REF_CLK/CK must be PCLK/PLL in either bank.
DM/DQS for each byte must follow the rest of the group. CS in either group.
Layout length matching groups: Data: DQ/DQM/DQS± (low byte/upper byte) Address/command: BA/A/~RAS~/~CAS~/~WE~ Control: ~CS~, CKE, ODT Clock: CK±
NOTE: requires differential PCLK ODT of 100R.
NOTE: float EN to enable; ground to disable.
NOTE: safe to switch LVDS +/-, so swapped here for layout.
100MHz LVDS Clock for DDR PLL
Skew: DQS± ±1mils, ±10mils nets in byte Close to CK Close to CK ±1mils, longest trace
SDRAM_VDD
SDRAM_VDDQ
Note: I/O (VDDQ) can have less cap than core (VDD)
NOTE: since we have a single chip we can rely on ODT for the addr/ctrl/clk termination. If we had more we'd need 50R termination to VTT.
TODO: add 10k pulldown on ~SDRAM_RESET
Layout on sides of chip as in TN-41-13 fig 3
NOTE: since we are <=2 chips we can avoid full VTT regulation and use a resistor divider to get VTTREF.
Layout in-between FPGA and SDRAM.
SDRAM Decoupling
DDR3L VTTREF Divider
Use 1% resistors.

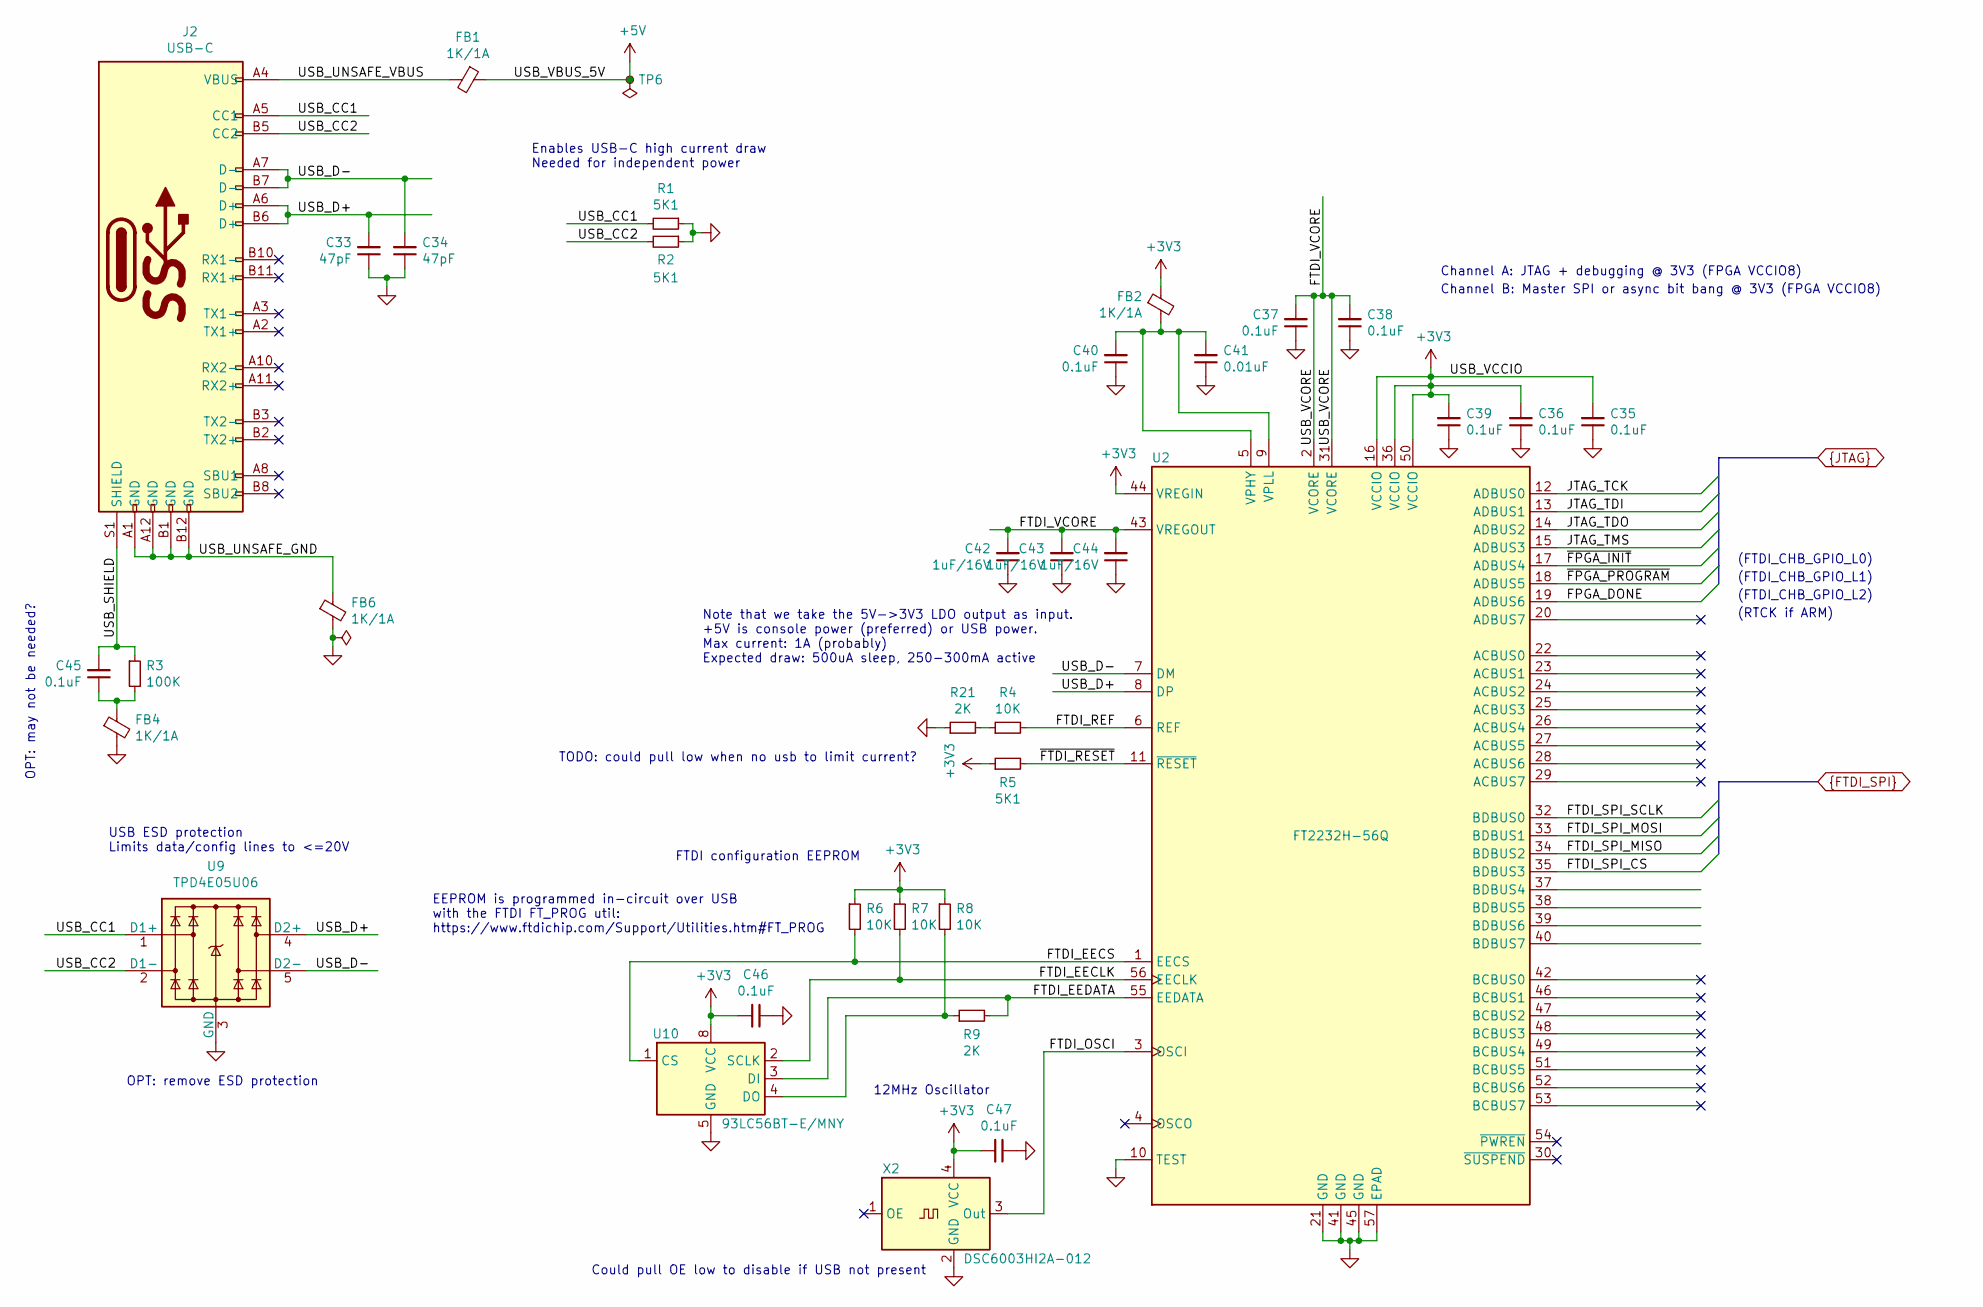
[picture p8: schematic accelerator-devkit-proto-0-baseboard-usb-io.kicad_sch, USB I/O]

Parts:
C33, C34: 47pF; C_0402_1005Metric
C35, C36, C37, C38, C39, C40, C45, C46, C47: 0.1uF; C_0402_1005Metric
C41: 0.01uF; C_0201_0603Metric
C42, C43, C44: 1uF/16V; C_0402_1005Metric
FB1, FB2, FB4, FB6: 1K/1A; L_0805_2012Metric; Part NFZ2MSD102SZ10L
J2: USB-C; CUI_UJ31-CH-3-MSMT-TR-67
R1, R2, R5: 5K1; R_0402_1005Metric
R3: 100K; R_0402_1005Metric
R4, R6, R7, R8: 10K; R_0402_1005Metric
R9, R21: 2K; R_0402_1005Metric
TP6: TestPoint_Small; TestPoint_THTPad_D1.0mm_Drill0.5mm
U2: FT2232H-56Q; QFN-56-1EP_8x8mm_P0.5mm_EP5.9x5.9mm_ThermalVias
U9: TPD4E05U06; USON-10_2.5x1.0mm_P0.5mm
U10: 93LC56BT-E/MNY; WDFN-8-1EP_3x2mm_P0.5mm_EP1.3x1.4mm
X2: DSC6003HI2A-012; Oscillator_SMD_Microchip_VFLGA-4Pin_1.6x1.2mm

Connections:
+3V3: C35.2, C36.2, C39.2, C46.2, C47.2, FB2.1, R5.1, R6.1, R7.1, R8.1, U2.16 (VCCIO), U2.36 (VCCIO), U2.44 (VREGIN), U2.50 (VCCIO), U10.8 (VCC), X2.4 (VCC); also elsewhere on the board
+5V: FB1.1, TP6.1; also elsewhere on the board
/USB-I/O/FTDI_EECLK: R7.2, U2.56 (EECLK), U10.2 (SCLK)
/USB-I/O/FTDI_EECS: R6.2, U2.1 (EECS), U10.1 (CS)
/USB-I/O/FTDI_EEDATA: R9.2, U2.55 (EEDATA), U10.3 (DI)
/USB-I/O/FTDI_OSCI: U2.3 (OSCI), X2.3 (Out)
/USB-I/O/FTDI_REF: R4.2, U2.6 (REF)
/USB-I/O/FTDI_VCORE: C37.2, C38.2, C42.2, C43.2, C44.2, U2.2 (VCORE), U2.31 (VCORE), U2.43 (VREGOUT)
/USB-I/O/USB_CC1: J2.A5 (CC1), R1.2, U9.1 (D1+), U9.10 (D1+)
/USB-I/O/USB_CC2: J2.B5 (CC2), R2.2, U9.2 (D1-), U9.9 (D1-)
/USB-I/O/USB_D+: C33.2, J2.A6 (D+), J2.B6 (D+), U2.8 (DP), U9.4 (D2+), U9.7 (D2+)
/USB-I/O/USB_D-: C34.2, J2.A7 (D-), J2.B7 (D-), U2.7 (DM), U9.5 (D2-), U9.6 (D2-)
/USB-I/O/USB_SHIELD: C45.2, J2.S1 (SHIELD), R3.1
/USB-I/O/USB_UNSAFE_GND: FB6.1, J2.A1 (GND), J2.A12 (GND), J2.B1 (GND), J2.B12 (GND)
/USB-I/O/USB_UNSAFE_VBUS: FB1.2, J2.A4 (VBUS), J2.A9 (VBUS), J2.B4 (VBUS), J2.B9 (VBUS)
/USB-I/O/~FTDI_RESET: R5.2, U2.11 (~RESET)
FPGA_DONE: U2.19 (ADBUS6); also elsewhere on the board
FTDI_SPI_CS: U2.35 (BDBUS3); also elsewhere on the board
FTDI_SPI_MISO: U2.34 (BDBUS2); also elsewhere on the board
FTDI_SPI_MOSI: U2.33 (BDBUS1); also elsewhere on the board
FTDI_SPI_SCLK: U2.32 (BDBUS0); also elsewhere on the board
GND: C33.1, C34.1, C35.1, C36.1, C37.1, C38.1, C39.1, C40.1, C41.1, C42.1, C43.1, C44.1, C46.1, C47.1, FB4.2, FB6.2, R1.1, R2.1, R21.1, U2.10 (TEST), U2.21 (GND), U2.41 (GND), U2.45 (GND), U2.57 (EPAD), U9.3 (GND), U9.8 (GND), U10.5 (GND), X2.2 (GND); also elsewhere on the board
JTAG_TCK: U2.12 (ADBUS0); also elsewhere on the board
JTAG_TDI: U2.13 (ADBUS1); also elsewhere on the board
JTAG_TDO: U2.14 (ADBUS2); also elsewhere on the board
JTAG_TMS: U2.15 (ADBUS3); also elsewhere on the board
unnamed: C40.2, C41.2, FB2.2, U2.5 (VPHY), U2.9 (VPLL)
unnamed: C45.1, FB4.1, R3.2
unnamed: R8.2, R9.1, U10.4 (DO)
unnamed: R4.1, R21.2
~FPGA_INIT: U2.17 (ADBUS4); also elsewhere on the board
~FPGA_PROGRAM: U2.18 (ADBUS5); also elsewhere on the board

Notes on the sheet:
OPT: may not be needed?
USB ESD protection Limits data/config lines to <=20V
OPT: remove ESD protection
EEPROM is programmed in-circuit over USB with the FTDI FT_PROG util: https://www.ftdichip.com/Support/Utilities.htm#FT_PROG
Enables USB-C high current draw Needed for independent power
FTDI configuration EEPROM
Note that we take the 5V->3V3 LDO output as input. +5V is console power (preferred) or USB power. Max current: 1A (probably) Expected draw: 500uA sleep, 250-300mA active
12MHz Oscillator
TODO: could pull low when no usb to limit current?
Could pull OE low to disable if USB not present
Channel A: JTAG + debugging @ 3V3 (FPGA VCCIO8)
Channel B: Master SPI or async bit bang @ 3V3 (FPGA VCCIO8)
(FTDI_CHB_GPIO_L0)
(FTDI_CHB_GPIO_L1)
(FTDI_CHB_GPIO_L2)
(RTCK if ARM)

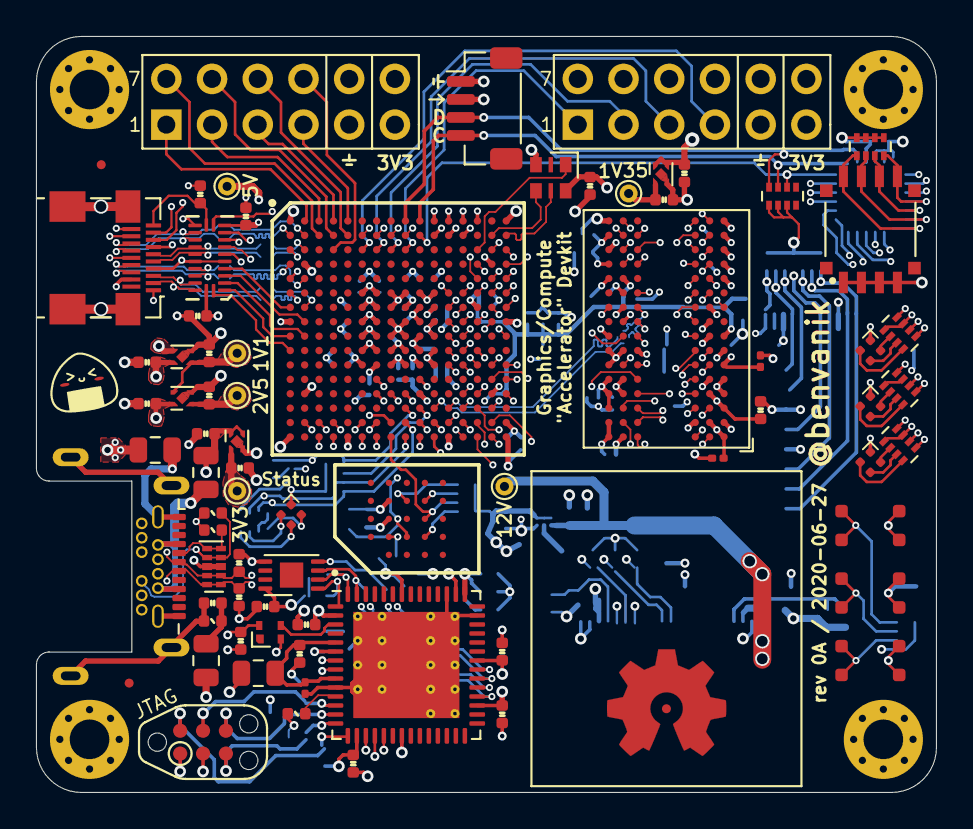
[picture p9: board accelerator-devkit-proto-0-baseboard.kicad_pcb from above]

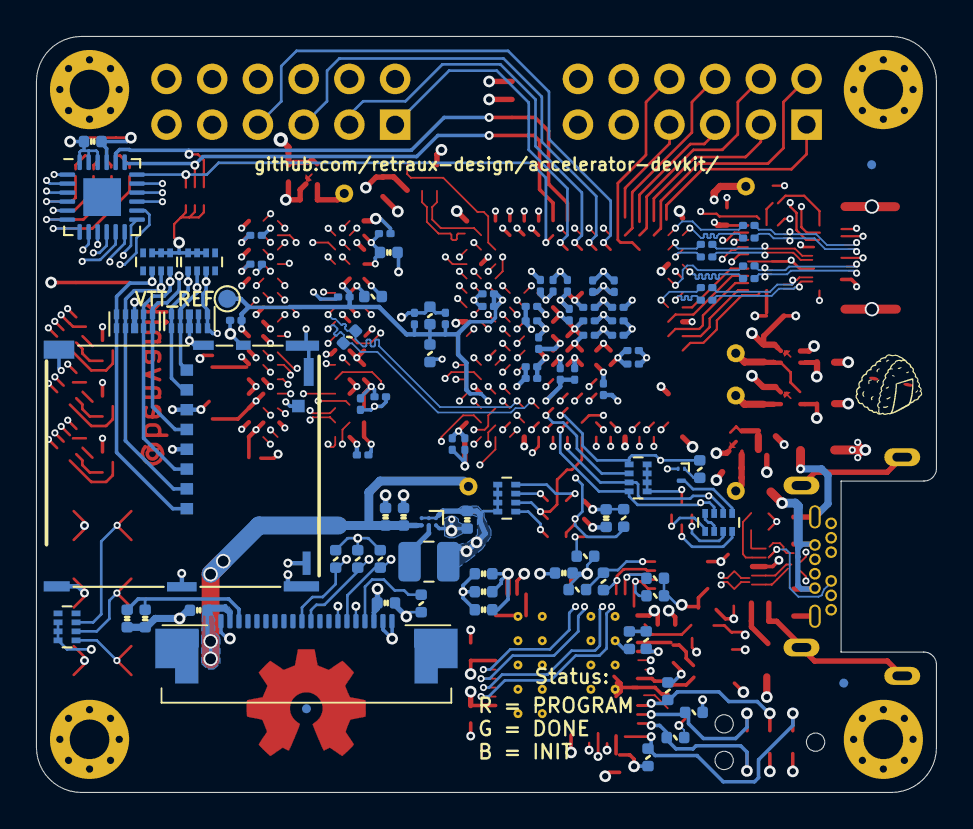
[picture p10: board accelerator-devkit-proto-0-baseboard.kicad_pcb from below]

Board: 6 copper layers, 50.0 x 42.0 mm, 174 parts (95 on the bottom side), 192 nets.
