retraux-design/accelerator-devkit/(commit log)

2020-06-26 Initial revision 0
    Untested!
    [accelerator-devkit-proto-0-baseboard-display-io.kicad_sch, accelerator-devkit-proto-0-baseboard-fpga-config.kicad_sch, accelerator-devkit-proto-0-baseboard-fpga-io.kicad_sch, accelerator-devkit-proto-0-baseboard-hdmi-io.kicad_sch, accelerator-devkit-proto-0-baseboard-power.kicad_sch, accelerator-devkit-proto-0-baseboard-sdram.kicad_sch, accelerator-devkit-proto-0-baseboard-usb-io.kicad_sch, accel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]
2020-06-26 Removing unused MP Pin on Qwiic connector
    [accelerator-devkit-proto-0-baseboard-display-io.kicad_sch, accelerator-devkit-proto-0-baseboard-fpga-io.kicad_sch, accelerator-devkit-proto-0-baseboard-usb-io.kicad_sch]
2020-06-26 Adding logo connections between schematic and PCB.
    [accelerator-devkit-proto-0-baseboard-power.kicad_sch, accelerator-devkit-proto-0-baseboard.kicad_pcb, accelerator-devkit-proto-0-baseboard.kicad_sch]
2020-06-26 Adding TODO for adding more GND stitch vias near DDR
    [accelerator-devkit-proto-0-baseboard.kicad_pcb]
2020-06-26 Adding silkscreen annotations to Qwiic connector
    [accelerator-devkit-proto-0-baseboard.kicad_pcb]
2020-06-26 Adding additional silkscreen info
    [accelerator-devkit-proto-0-baseboard-fpga-config.kicad_sch, accelerator-devkit-proto-0-baseboard-usb-io.kicad_sch, accelerator-devkit-proto-0-baseboard.kicad_pcb]
2020-06-26 Fixing Qwiic courtyard
    [accelerator-devkit-proto-0-baseboard.kicad_pcb]
2020-06-26 Fixing 1V35 silkscreen label size
    [accelerator-devkit-proto-0-baseboard.kicad_pcb]
2020-06-26 Fixing silkscreen text sizes
    [accelerator-devkit-proto-0-baseboard.kicad_pcb]
2020-06-26 Adding some ground stitch vias
    [accelerator-devkit-proto-0-baseboard.kicad_pcb]
2020-06-26 Thickening sDRAM_VREF traces
    [accelerator-devkit-proto-0-baseboard.kicad_pcb]
2020-06-26 Length matching SDRAM upper byte
    [accelerator-devkit-proto-0-baseboard.kicad_pcb]
2020-06-27 Length matching SDRAM lower byte
    [accelerator-devkit-proto-0-baseboard.kicad_pcb]
2020-06-27 Length matching SDRAM In3.Cu nets
    [accelerator-devkit-proto-0-baseboard.kicad_pcb]
2020-06-27 Cleaning up messy overlapping traces
    [accelerator-devkit-proto-0-baseboard.kicad_pcb]
2020-06-27 Retuning lengths after cleanup
    [accelerator-devkit-proto-0-baseboard.kicad_pcb]
2020-06-27 Removing TODO now that lengths are matched
    [accelerator-devkit-proto-0-baseboard.kicad_pcb]
2020-06-27 Removing top/bottom ground pours
    [accelerator-devkit-proto-0-baseboard.kicad_pcb]
2020-06-27 Spreading out display SDIO nets
    [accelerator-devkit-proto-0-baseboard.kicad_pcb]
2020-06-27 Moving all power rail test points to the front
    [accelerator-devkit-proto-0-baseboard-display-io.kicad_sch, accelerator-devkit-proto-0-baseboard-fpga-config.kicad_sch, accelerator-devkit-proto-0-baseboard-fpga-io.kicad_sch, accelerator-devkit-proto-0-baseboard-usb-io.kicad_sch, accelerator-devkit-proto-0-baseboard.kicad_pcb, accelerator-devkit-proto-0-baseboard.kicad_sch]
2020-06-27 Bumping board datestamp
    [accelerator-devkit-proto-0-baseboard.kicad_pcb]
2020-06-27 Removing VTT_REF roundabout
    [accelerator-devkit-proto-0-baseboard.kicad_pcb]
2020-06-27 Moving traces in from the board edge
    [accelerator-devkit-proto-0-baseboard.kicad_pcb]
2020-06-27 Onigiri <3
    [accelerator-devkit-proto-0-baseboard.kicad_pcb]
2020-06-28 Switching USB connector to CUI UJ31-CH-3-MSMT-TR-67
    [accelerator-devkit-proto-0-baseboard-display-io.kicad_sch, accelerator-devkit-proto-0-baseboard-fpga-io.kicad_sch, accelerator-devkit-proto-0-baseboard-hdmi-io.kicad_sch, accelerator-devkit-proto-0-baseboard-power.kicad_sch, accelerator-devkit-proto-0-baseboard-usb-io.kicad_sch, accelerator-devkit-proto-0-baseboard.kicad_pcb, accelerator-devkit-proto-0-baseboard.kicad_sch]
2020-06-28 Adding fiducials and marking as rev 0A
    [accelerator-devkit-proto-0-baseboard-display-io.kicad_sch, accelerator-devkit-proto-0-baseboard-fpga-config.kicad_sch, accelerator-devkit-proto-0-baseboard-fpga-io.kicad_sch, accelerator-devkit-proto-0-baseboard-hdmi-io.kicad_sch, accelerator-devkit-proto-0-baseboard-power.kicad_sch, accelerator-devkit-proto-0-baseboard-sdram.kicad_sch, accelerator-devkit-proto-0-baseboard-usb-io.kicad_sch, accel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]
